ameesme/little-camera/docs/mood.md

# Mood

The camera wants to be used. Left alone it gets anxious over a week and asks for attention, the way a tamagotchi would but quieter. The face and sound follow **how long ago the last photo was taken, capped by battery level**; the daily chirp times are independent of photos. Built and running on board 1, host-tested over a simulated month, but the first real week on hardware is still ahead.

`happiness` is 1.0 the moment a photo is saved and falls linearly to 0.0 over 7 days without one. Taking a photo resets the time-based happiness and schedules a chirp about an hour later, without changing the daily chirp times. Low battery can still make a freshly used camera look and sound unhappy.

| Since last photo | Happiness | Face | Sound |
|---|---|---|---|
| 0 – 1 h | 1.0 – 0.99 | asleep, eyes lifted | happy; extra chirp at ~1 h |
| 1 h – 24 h | 0.99 – 0.86 | eyes lifted | happy |
| 1 – 3 d | 0.86 – 0.57 | eyes go flat | harmonic, with the odd slide |
| 3 – 5 d | 0.57 – 0.29 | mouth stretches flat | off-scale, a sweep or short hiss creeps in |
| 5 – 7 d | 0.29 – 0.0 | mouth turned down | dissonant, noisy, sweeps both ways |
| > 7 d | 0.0 | as sad as it gets | the same, no further escalation |

The eyes carry the happiness, so the happy face needs no smile — just lifted eyes over the same square mouth. Below the top band they go flat and stay flat and the mouth does the rest. The face breathes for its first two minutes, and a tap restarts that window, since it means someone is there. After it the sleep tick stretches to 60 s, still checking for due chirps.

## Battery mood

The battery icon and mood use the same hysteretic bars from `power.h`:

- **Low (two bars):** happiness is capped at 127, the glum band. Enter below 35%; recover to three bars at 45%.
- **Empty (one bar):** happiness is capped at 63, the sad band. Enter below 15%; recover to two bars at 20%. “Empty” here means the icon's empty state, not a zero-volt battery.
- Battery can only worsen the time-based mood. A naturally sad camera stays sad when charged; charging removes the battery limit as its percentage recovers.

This is applied to sleep and awake faces, mood chirps and the `happiness` sent to the phone. The happy charger-connection chirp remains an acknowledgement of power arriving. Battery does not change photo timestamps, the neglect clock, the daily chirp schedule or the persisted time-based mood. ADC samples are shared with telemetry, refreshed at most every five seconds in the viewfinder or when charge/USB status changes; sleep continues using its existing battery ticks.

## The rules

- **Time spent powered off does not count.** There is no clock battery, so mood state is persisted in NVS and resumed on boot: a camera that was sad when the battery died wakes up just as sad as it was, and catches up as soon as a phone sends the date. Durations are known from the first boot; the time of day only after a `SET_TIME` with a UTC offset (`protocol.md` §3).
- **Three or four attention chirp times are picked at random each day**, between 08:00 and 22:00 local, in addition to the chirp 55–65 minutes after a photo. They start on the first day and taking photos does not reset them. The schedule is persisted so restarting does not re-roll it. On a partial first day, past times are skipped; missed times do not pile up into a burst.
- **Before local time is known**, the daily schedule uses repeating 24-hour periods of powered-on time, resumed across restarts, with random times throughout each period. Once the phone supplies local time, it switches to the local day. Until the phone sets the clock again after a restart, the saved schedule clock continues from where it stopped.
- **Nothing between 22:00 and 08:00 local**, when local time is known. Before local time has ever been known, the night rule is skipped and the chirp still plays. That is deliberate: a camera that has never met a phone should still be heard.
- **A chirp waits for a quiet screen.** Only the viewfinder or the sleep face, button up, nothing playing, no transfer running. It never interrupts the save screen, the gallery or a slide.
- **A tap on a sleeping camera answers in its current mood** without waking it and without counting as activity, so a press in a bag both explains itself and says how the camera is doing.
- **Every chirp is composed on the spot.** The score is a pure function of a seed and the happiness, so any chirp can be reproduced on a laptop: `tools/chirp` renders scores to WAV and `tools/hosttest` checks the invariants (≤300 ms, 2–3 segments, the A major scale while happy).

## Testing it

`tools/hosttest` runs a simulated month through the state machine and checks every rule above. On the bench, `-DLC_MOOD_FAST` runs the mood clock 600× — the week in about seventeen minutes — so the whole arc plays out in one sitting, faces included. Every chirp and state save is a serial line.

Open: whether the one-hour chirp should also play while the phone is syncing. It waits today.
