ameesme/little-camera/docs/protocol.md

# Little Camera protocol

The single source of truth for how the three parties talk. The firmware (`firmware/src/sync.cpp`), the iOS bridge (`app/ios/LittleCamera/BLE/Protocol.swift`) and the server (`server/src/routes/camera.ts`) are all written from this file. Change it here first.

```
┌──────────┐   BLE (GATT)   ┌──────────┐   HTTPS (JSON / PBM)   ┌──────────┐
│  camera  │ ─────────────▶ │  iPhone  │ ─────────────────────▶ │  server  │
│ ESP32-S3 │ ◀───────────── │  bridge  │ ◀───────────────────── │  blog    │
└──────────┘                └──────────┘                        └──────────┘
```

The phone is a dumb pipe. It never authenticates as a person; it authenticates **as the camera**, using an id and a secret it read from the camera over an encrypted BLE link. Making a blog, showing the QR verification picture and approving subscribers are all camera-scoped API calls the app makes; the web keeps only the two things a person must do out of band, in their own mail client: confirming the address and letting a phone in. Firmware travels the same pipe backwards — server to phone over HTTPS (§4.7), phone to camera over BLE (§3.7) — and is verified at the far end, so the pipe stays dumb.

Hosts: the service is `lttl.cam`. A blog is one label under it (`mees.lttl.cam`), the landing page owns `lttl.cam/`, and everything this server answers on that domain sits under `/api` (machines) or `/app` (people) so a proxy can tell the two apart.

All multi-byte integers on BLE are **little-endian**. All timestamps are **unix seconds, UTC**.

---

## 1. Identity

| Name | Definition | Example |
|---|---|---|
| `camera_id` | The camera's Bluetooth MAC (`esp_read_mac(..., ESP_MAC_BT)`), 12 lowercase hex characters, no separators | `7cdfa1e2b3c4` |
| `secret` | 16 random bytes generated once on first boot (`esp_fill_random`), stored in NVS. Sent as 32 lowercase hex characters over HTTP | `9f2c…` |
| `short_code` | 6 characters derived from `camera_id` (below). Shown in the app and on the camera, so a human can tell two cameras apart | `KQ7M2X` |
| BLE device name | `lc-` + last 4 hex characters of `camera_id`, uppercase | `lc-B3C4` |

### Alphabet

Codes that a human may have to read or type use this 32-character alphabet (no `0 O 1 I`):

```
ABCDEFGHJKLMNPQRSTUVWXYZ23456789
```

Index 0 = `A` … index 31 = `9`.

### `short_code` derivation

```
h = sha256(ascii bytes of camera_id)          # 32 bytes
v = h[0]<<32 | h[1]<<24 | h[2]<<16 | h[3]<<8 | h[4]   # first 40 bits, big-endian
code = ""
for i in 0..5:
    code += ALPHABET[(v >> (35 - 5*i)) & 31]   # six 5-bit groups from the top, 30 bits used
```

Test vectors (the C, Swift and TS implementations are all checked against these):

| `camera_id` | `short_code` |
|---|---|
| `7cdfa1e2b3c4` | `MM48F3` |
| `000000000000` | `882TLC` |
| `ffffffffffff` | `XMPHSF` |
| `a1b2c3d4e5f6` | `ZZWB7E` |

---

## 2. Photo file format

Photos are binary **PBM (P4)**, 320×240, exactly as the firmware stores them. A set bit is **black** (PBM convention). Rows are 40 bytes, MSB first, no padding. Files written by firmware from this version on carry one comment line:

```
P4
# boot=17 up=48213 t=1757789000
320 240
<9600 bytes of raster>
```

| Field | Meaning |
|---|---|
| `boot` | Boot counter (NVS) at capture time |
| `up` | `millis()` at capture time |
| `t` | Unix time at capture time, `0` if the camera did not know the time (no phone had connected since boot) |

Files from older firmware have no comment line. Every reader must accept both. Readers must skip any `#` comment between tokens, per the PBM spec.

Dating rule (applied by the phone at sync time, and by the server as a fallback):

1. `t > 0` → `captured_at = t`, source `camera`.
2. else if `boot == Info.boot` (same boot as now) → `captured_at = now − (Info.uptime_ms − up) / 1000`, source `phone`.
3. else → `captured_at = upload time`, source `upload`. Ordering by `camera_index` is preserved server-side by subtracting one second per position when several such photos arrive in one batch.

---

## 3. BLE GATT service

Base UUID `1C0000xx-4C43-4D52-8000-6C6974746C65` (`4C43 4D52` = "LCMR", suffix spells `little`).

| xx | Name | Properties | Size |
|---|---|---|---|
| `01` | Service | advertised in the primary advertisement | |
| `02` | `Info` | READ | 25 bytes |
| `03` | `Secret` | READ, **encrypted + authenticated** (bonded, passkey) | 16 bytes |
| `04` | `Control` | WRITE (with response) | 1–37 bytes |
| `05` | `Data` | NOTIFY | up to MTU − 3 |
| `06` | `Update` | WRITE (without response) | up to MTU − 3 |

Advertising: connectable, 100 ms interval, service UUID `…01` in the advertisement so iOS background scans match it. The camera advertises while awake and for a while behind the sleep face, not in light sleep (see §3.6).

MTU: the camera requests 512. The usable notification payload is `MTU − 3` ATT bytes; the frame header takes 3, so `chunk = MTU − 6` (iOS typically grants 185 or 251 → 179 or 245-byte chunks; a 9.6 KB photo is ~40–55 notifications).

### 3.1 `Info` (READ)

| Offset | Type | Field |
|---|---|---|
| 0 | u8 | `version` = 3 |
| 1 | u8[6] | `mac` (same bytes as `camera_id`, in order) |
| 7 | u16 | `photo_count` |
| 9 | u16 | `unsynced_count` |
| 11 | u16 | `newest_index` (0 if no photos) |
| 13 | u16 | `boot` |
| 15 | u32 | `uptime_ms` |
| 19 | u32 | `epoch` (0 if the clock is unset) |
| 23 | u8 | `flags`: bit0 `time_valid`, bit1 `storage_ok`, bit2 `busy` (a stream is running), bit3 `trial` (running an update that has not been confirmed yet, §7), bit4 `usb` (VBUS present), bit5 `charging` (VBUS present and the charger pulling) |
| 24 | u8 | `fw_major` |
| 25 | u8 | `fw_minor` |
| 26 | u8 | `fw_patch` |
| 27 | u8 | `update_state` (§3.7: 0 idle, 1 receiving, 2 verifying, 3 ready, 4 failed) |
| 28 | u32 | `update_space` — bytes the inactive firmware slot can take, 0 if the camera cannot update itself |
| 32 | u16 | `vbat_mv` — battery millivolts, the mean of 16 ADC reads doubled back through the 1M/1M divider |
| 34 | u8 | `battery_percent` — 0–100, the camera's own reading of its curve |
| 35 | u32 | `used_bytes` — LittleFS bytes in use |
| 39 | u32 | `total_bytes` — LittleFS bytes total, 0 if the mount failed |
| 43 | u8 | `happiness` — 0–255 ([mood](mood.md)), including battery mood limits: low caps at glum (127), empty at sad (63), following the camera's battery bars and hysteresis. The face is `happiness >> 6`, the same split the camera draws |
| 44 | u32 | `mood_elapsed_s` — seconds since the last photo on the mood clock, which runs without a wall clock |

48 bytes. Read it after connecting and after every `ACK`; it is not notified.

**The percentage comes from the camera, not from the reader.** `vbat_mv` is there to be shown beside it and to calibrate the curve against a real discharge, not for a phone to invent its own number from. On USB the charge current pulls the reading up, which is what `charging` is for: show the percentage and say it is charging, rather than pretending the number means the same thing.

### 3.2 `Secret` (READ, encrypted)

16 raw bytes. Reading it triggers pairing on first contact: the camera uses **passkey display** — the six digits take over its screen (`Display::drawPairing`, not a toast) until the phone reports the outcome or a minute passes — and the phone asks the user to type them. After bonding the read succeeds silently on every reconnect. The phone stores the secret in the Keychain and never asks again.

### 3.3 `Control` (WRITE)

`[u8 op][args…]`

| op | Name | Args | Effect |
|---|---|---|---|
| `0x01` | `SET_TIME` | `u32 epoch` [, `i16 utc_offset_min`] | Sets the camera clock. Photos taken afterwards carry `t=`. The optional offset (minutes east of UTC, e.g. 120 for CEST) gives the camera local time for its night rule ([mood.md](mood.md)); a 4-byte write is still accepted and leaves any stored offset alone |
| `0x02` | `LIST` | `u16 from_index`, `u8 flags` (bit0 = unsynced only) | Streams `LIST_DATA` frames, ascending index, starting at `from_index` (inclusive) |
| `0x03` | `GET` | `u16 index`, `u32 offset` | Streams the raw file (header + raster) from `offset` as `PHOTO_DATA` frames |
| `0x04` | `ACK` | `u16 index` | The phone has the file safely. Camera marks it synced (rename `/0007.pbm` → `/0007s.pbm`) |
| `0x05` | `DELETE` | `u16 index` | Deletes the file. The bridge does not use this by default |
| `0x06` | `ABORT` | | Stops the running stream |
| `0x07` | `PROMPT` | `u8 kind` | What the phone is waiting for: `0` nothing, `1` the verification card (§5), `2` the picture that heads the blog, `3` say hello (the phone is showing the owner that the two have found each other, so the panel says it too and returns by itself). The camera wakes if it was asleep, names the shot on its own screen, and goes back to `0` by itself once a photo is saved. Purely cosmetic: the kind of an uploaded photo is still decided server-side (§4.3) |
| `0x08` | `CHIRP` | `u8 times` (1..3) | The camera chirps in its current mood, that many times. For a step on the phone that the camera should be noticed for; it draws nothing and changes nothing |
| `0x10` | `UPDATE_BEGIN` | `u32 size`, `u8[32] sha256` | Opens a firmware update session (§3.7) for an image of `size` bytes with that SHA-256. Answered with `UPDATE_STATUS` |
| `0x11` | `UPDATE_END` | | Every byte is in: verify, arm the new slot, reboot |
| `0x12` | `UPDATE_ABORT` | | Throws the half-written image away. The running firmware is untouched |

Only one stream runs at a time; a `LIST`/`GET` while busy ends immediately with status `busy`. An open update session counts as busy for both, and `UPDATE_BEGIN` while a photo stream runs is answered `busy` in turn. Writes are processed on the camera's main loop, not in the BLE callback, so a response frame can lag a write by one loop iteration (~30 ms).

### 3.4 `Data` (NOTIFY)

Frame: `[u8 kind][u16 seq][payload]`

| kind | Name | Payload |
|---|---|---|
| `0x01` | `LIST_DATA` | 1..N entries of 16 bytes (below) |
| `0x02` | `PHOTO_DATA` | raw file bytes |
| `0x03` | `UPDATE_STATUS` | 15 bytes, §3.7 |
| `0x7F` | `END` | `u8 op`, `u8 status`, `u32 total_len`, `u32 crc32` |

`seq` starts at 0 for each stream and increments by one per frame; `END` carries the next value. `total_len` is the number of payload bytes streamed (for `GET`: bytes from `offset` to end of file). `crc32` is the IEEE CRC-32 of those payload bytes (for `GET` with `offset > 0` it covers only the streamed part). An update session is a stream of its own for this purpose: `seq` restarts at 0 on `UPDATE_BEGIN` and counts `UPDATE_STATUS` frames.

`status`: `0` ok, `1` not found, `2` aborted, `3` storage error, `4` busy, `5` bad image, `6` offset (resume at `next_offset`), `7` too large.

`LIST_DATA` entry (16 bytes):

| Offset | Type | Field |
|---|---|---|
| 0 | u16 | `index` |
| 2 | u8 | `flags`: bit0 `synced`, bit1 `epoch_is_estimate` (from uptime), bit2 `epoch_from_clock` |
| 3 | u8 | reserved |
| 4 | u32 | `size` (bytes on disk, header included) |
| 8 | u32 | `epoch` (0 unknown; already computed with the dating rule in §2 where possible) |
| 12 | u32 | `uptime_ms` at capture (`up`) |

### 3.5 Bridge algorithm (what the phone does on every connection)

```
connect → read Info → if Secret unknown: read Secret (pair)
SET_TIME(now, utc_offset_min)
LIST(from_index = 1, flags = unsynced_only)
for each entry ascending:
    GET(index, 0)                     # resume with offset after a disconnect
    verify seq continuity + crc32
    upload to server (§4.3); 200/201/409 all count as success
    ACK(index)
read Info; done when unsynced_count == 0
```

### 3.6 Power rules

- The camera runs the radio while awake and for 30 s after the 20 s idle timeout: the sleep face is already up, but the chip keeps advertising behind it, which gives a backgrounded iPhone time to notice.
- While a phone is connected and active (connect, write, notification, ACK within the last 60 s) that window stretches.
- Then light sleep tears the BLE stack down; a one-second hold on the shutter wakes the camera and brings the radio back.
- Pressing the shutter always wins; a transfer in progress simply continues alongside.
- A firmware update (§3.7) holds the camera awake for as long as it runs: no idle timeout, no light sleep, and the sensor is powered down to leave the radio and the flash writer alone.

### 3.7 Firmware update session

The phone pushes an image to the camera's spare firmware slot. Why this shape:
the camera is a peripheral and cannot fetch anything itself, the ESP32-S3 has a
second 3.3 MB app slot sitting empty, and the whole point is that nothing the
phone does to a half-written slot can stop the camera from booting what it is
running now.

`Update` writes are `[u32 offset][data]`, written **without response** — one ATT
acknowledgement per 500 bytes would halve the throughput and the offset already
makes a lost write recoverable. The camera only accepts `offset == next_offset`;
anything else is dropped and answered with status `offset` carrying the offset
it does want, and the phone rewinds there.

Flow control is a window, because the camera stages chunks in RAM and writes
them to flash from its main loop, and a phone that outruns it would lose the
overflow. `UPDATE_BEGIN` answers with the `chunk` and `window` the camera can
take; the phone may have `window` bytes outstanding beyond the last
`next_offset` it was told, and the camera sends an unsolicited `UPDATE_STATUS`
(`op = 0x00`) roughly every half window to move it along — and always on the
last byte of the image, however little of a window it took, since that is the
one the phone is waiting for before it sends `UPDATE_END`.

`UPDATE_STATUS` payload (15 bytes):

| Offset | Type | Field |
|---|---|---|
| 0 | u8 | `op` — the control op this answers, or `0x00` for a progress report |
| 1 | u8 | `status` (§3.4) |
| 2 | u8 | `state`: 0 idle, 1 receiving, 2 verifying, 3 ready (about to reboot), 4 failed |
| 3 | u32 | `next_offset` — what the camera wants next, i.e. how much it has accepted |
| 7 | u32 | `total` — the size it is expecting |
| 11 | u16 | `chunk` — most data bytes per `Update` write |
| 13 | u16 | `window` — bytes the phone may have in flight beyond `next_offset` |

What the phone does:

```
read Info                                  # version >= 2 and update_space >= size, or stop
UPDATE_BEGIN(size, sha256)
→ UPDATE_STATUS(status=ok, next_offset, chunk, window)   # next_offset > 0 resumes a session
while next_offset < size:
    write [next_offset][chunk bytes] until window is full, then wait for UPDATE_STATUS
    status=offset → rewind to the next_offset it reports
UPDATE_END
→ UPDATE_STATUS(status=ok, state=ready)    # then the camera reboots; the link drops
   status=offset → the camera is short after all; fill the gap and end again
reconnect, read Info, check fw_* is the new version
```

An `UPDATE_END` that arrives before every byte did is answered `offset`, not
`bad image`: a gap at the end is worth going back for, and the image on the
camera is only incomplete, not wrong. A session the phone abandons is not
ended by a disconnect either — the camera holds the half-written slot for 90
seconds, so reconnecting and repeating `UPDATE_BEGIN` with the same digest
resumes it rather than starting a megabyte again.

The camera's side of the bargain, which is what keeps a partial flash from
bricking it:

1. Bytes go to the **inactive** slot. The running firmware is never touched, so
   an abandoned update costs nothing but the re-send.
2. The slot is armed only after all `size` bytes arrived, the SHA-256 of the
   stream matches the one in `UPDATE_BEGIN`, and the bootloader's own image
   check passes.
3. The first boot of a new image is a **trial**: `Info.flags` bit3 says so. The
   firmware confirms itself once it is up and running; an image that crashes
   before that, three boots in a row, is rolled back to the slot it came from.
4. `UPDATE_ABORT`, a disconnect, or a camera reset during the transfer all end
   in the same place: the old firmware, still running, still bootable.

---

## 4. HTTP camera API

Base: `https://lttl.cam/api/camera`. JSON unless noted. Errors are `{ "error": "<code>", "message": "<human text>" }`.

Only two prefixes on that domain are the server's: `/api/…` for machines and `/app/…` for the two pages an emailed link opens — `/app/verify-email` and `/app/claim`. There is no owner session and no management on the web: the app does all of it over this API. Everything else, `/` above all, belongs to the landing page behind the same proxy. Blogs are unaffected, each owning the root of its own subdomain.

### 4.1 Authentication

```
Authorization: Camera <camera_id>:<secret_hex>
```

Every route except `hello` requires it. The server stores `sha256(secret)` and compares in constant time.

### 4.2 `POST /hello`

Body `{ "camera_id": "7cdfa1e2b3c4", "secret": "<32 hex>", "firmware": "0.2.0" }`.
First contact creates the camera (trust on first use). Later calls must present the same secret.
`firmware` is optional — the bridge sends what `Info` reported — and is only recorded, never trusted for anything.

Response `200`:

```json
{
  "camera_id": "7cdfa1e2b3c4",
  "short_code": "KQ7M2X",
  "bound": null | { "handle": "mees", "name": "Mees", "url": "https://mees.lttl.cam" },
  "server_time": 1757789000
}
```

### 4.3 `POST /photos`

Raw PBM body.

| Header | Required | Meaning |
|---|---|---|
| `Content-Type: image/x-portable-bitmap` | yes | |
| `X-Photo-Index: 7` | yes | `index` on the camera |
| `X-Captured-At: 1757789000` | no | phone's estimate when the file has `t=0` |
| `X-Captured-At-Source: phone` | no | `phone` or `upload` |

Size limit 16 KB. Must parse as `P4 320 240`.

Response `201` (new) or `200` (`"status": "duplicate"`, same `camera_id` + sha256 seen before):

```json
{
  "id": "k3m9q2z8x1w4",
  "status": "stored" | "duplicate",
  "kind": "photo" | "verification" | "avatar",
  "bound": null | { "handle": "mees", "name": "Mees", "url": "https://mees.lttl.cam" }
}
```

Server-side, in order: parse + hash → dedupe → date (rule in §2) → if the camera is unbound and any verification code is live, try to decode a QR (§5) → if bound and an avatar was requested and `captured_at` is after the request, this photo becomes the avatar.

### 4.4 `GET /status`

```json
{
  "camera_id": "7cdfa1e2b3c4",
  "short_code": "KQ7M2X",
  "bound": null | { "handle": "mees", "name": "Mees", "url": "…", "photo_count": 12 },
  "avatar": { "requested_at": 1757789000 | null, "has_avatar": false },
  "firmware": { "installed": "0.2.0" | null, "latest": null | { "version": "0.3.0", "size": 1481712, "sha256": "…", "url": "…", "notes": "…", "released_at": 1757789000 }, "update_available": false },
  "claim": "unbound" | "pending" | "approved",
  "pending": null | { "handle": "mees", "name": "Mees", "verified": false },
  "confirmed_email": null | "mees@example.com",
  "subscribers": [ { "id": 3, "email": "sanne@example.com", "name": "Sanne" | null, "status": "pending" | "approved" | "blocked", "added_by": "self" | "owner" } ],
  "server_time": 1757789000
}
```

`subscribers` is empty and `bound` is `null` until the camera is bound. `pending` is the blog this camera is being
set up for but has not photographed the code of yet (§4.9 approved it, §5 has not bound it), with `verified` saying
whether its address has been confirmed; it is how a phone that was closed mid-onboarding picks up where it left off
instead of making the blog a second time. `confirmed_email` is an address whose owner has opened the link in §4.9 but
has not named a blog yet, and is what `POST /blog` makes one from. `claim` is how far the phone has got with §4.9; the battery and the rest of the camera's own state are not here, because the phone reads them off `Info` (§3.1) and sends them the other way (§4.8).

### 4.5 Subscribers (bound cameras only)

- `POST /subscribers` `{ "email": "…", "name": "…" | null }` → `201 { "id": 4 }`. Owner-added subscribers are approved immediately and receive a welcome link.
- `POST /subscribers/:id/approve` → `200`. Sends the welcome link.
- `POST /subscribers/:id/block` → `200`. Reversible.
- `DELETE /subscribers/:id` → `200`. Not reversible: the row and its comments go.

### 4.6 `POST /request-avatar`

`{}` → `200 { "requested_at": 1757789000 }`. The next photo captured after this moment becomes the profile picture.

### 4.7 `GET /feed` (bound and claimed)

The owner's own blog as data, newest first. `403 unclaimed` until §4.9 is through.

```json
{
  "photos": [ { "id": "5jk7ferd11ap", "url": "…/photos/5jk7ferd11ap.png", "kind": "photo" | "avatar", "captured_at": 1757789000, "uploaded_at": 1757789100, "comments": [ { "id": 1, "name": "Sanne", "body": "…", "created_at": 1757789200 } ] } ],
  "next": "1757789100.0" | null
}
```

Twenty a page. Pass `next` back as `?before=` for the next one.

- `POST /feed/:id/comments` `{ "body": "…" }` → `201 { "name": "Mees" }`. The owner's own comment, under the blog's name: a claimed camera's blog is the owner's (§4.9), so the phone needs nothing further.
- `DELETE /feed/:id` → `200 { "ok": true }`. Takes the `id` out of `photos[]`. Not reversible: the row, its comments and the stored PBM go. `404 not_found` if the photo is not on this camera's blog.

### 4.8 `POST /telemetry`

What the phone read out of `Info` (§3.1), relayed so the blog and the app can show it:

```json
{ "battery_percent": 44, "battery_mv": 3820, "charging": false, "used_bytes": 1234567, "total_bytes": 6553600, "happiness": 200, "mood_elapsed_s": 90061 }
```

Stored as given. **The percentage is the camera's**: the server does not recompute it, and the blog shows no battery at all until a phone has sent one, because an invented number is worse than none.

`GET /handle?handle=<handle>` answers `{ handle, available }`, while the owner is still typing a new one. Whether that blog has confirmed its address is `pending.verified` in §4.4; the phone waits on it before asking for the verification photo, since an unconfirmed blog is a 404 to everyone.

### 4.9 Letting a phone in

The camera credential proves a camera, not a person. Reading a blog's pictures, comments and list is a person's business, so the phone asks the owner once, by email.

**The address comes first.** Nothing is named, and no row is written, until someone has opened a link sent
to the address they typed. A half-finished sign-up leaves a token that expires, not a blog nobody confirmed.

- `POST /claim` `{}` on a bound camera, or `{ "email": "…" }` on an unbound one → `200 { "state": "pending" }` and a mail to the owner. On an unbound camera the server mails whichever link fits: an address that already owns a blog gets `/app/claim?t=…` to let this phone into it, and an address it has never seen gets `/app/confirm?t=…` to start one. **The answer is identical either way**, so the form says nothing about who has a camera, and the app shows the same screen for both.
- Opening `/app/confirm?t=…` records the address against that camera, where `confirmed_email` in §4.4 reports it. It names no blog, because there is none yet.
- `POST /blog` `{ "name": "…", "handle": "…" }` → `201 { "handle", "url" }`. Names the blog for whatever `confirmed_email` holds; the address is never sent again, because the phone does not get to choose it at this point. `409 address_unconfirmed` before that link is opened, `409 already_bound` if the camera has a blog, `409 handle_taken` otherwise. The blog is verified from birth, the phone is let in on the spot, and `confirmed_email` is cleared. Binding is still the QR photo (§5), except that the app skips it for now and the server binds here instead.
- `GET /handle?handle=…` → `200 { "handle", "available" }`. So the app can say *taken* before the form is sent.
- `POST /verification-code` `{}` → `201 { "code": "KQ7M2X", "expires_at": … }`. The code the app draws as the QR (§5). `409 no_blog` until there is a blog to bind to, `409 already_bound` once the camera is on one.
- The claim mail links to `/app/claim?t=…`, which **asks** and grants nothing; the `POST` behind its button is what approves. Mail clients prefetch links, so a GET must not be the grant. Confirming an address is not a grant — it says only that the address is reachable — so `/app/confirm` needs no such button.
- The approval names the camera *and* the blog, so a link cannot be replayed onto another phone, and an approval for one blog does not follow the camera to another.

### 4.10 Firmware releases

Two routes under `/api/firmware`, both **unauthenticated**: a firmware image is
not a secret, and leaving it open means a proxy or a CDN can cache it and a
person can `curl` it.

`GET /api/firmware/latest?hardware=v3q&channel=stable&installed=0.2.0`

```json
{
  "version": "0.3.0",
  "channel": "stable",
  "hardware": "v3q",
  "size": 1481712,
  "sha256": "<64 hex>",
  "url": "https://lttl.cam/api/firmware/v3q/0.3.0.bin",
  "notes": "Firmware update over BLE.",
  "released_at": 1757789000,
  "update_available": true
}
```

`hardware` defaults to `v3q`, `channel` to `stable`. `installed` is
optional and only decides `update_available`, which compares the two versions
as dotted numbers (`0.10.0` is newer than `0.9.9`). `404 { "error": "no_release" }`
when that channel has nothing published.

The phone offers and sends firmware only when the published version is numerically
newer than the version in the connected camera's Info. Equal, older or malformed
versions must not start a transfer, even if a cached server response says an update is available.

`GET /api/firmware/<hardware>/<version>.bin` → the image, `application/octet-stream`,
with `ETag` (its SHA-256) and an immutable `Cache-Control`. The `sha256` above
is what the phone puts in `UPDATE_BEGIN`, so the camera verifies the bytes end
to end — the server, the CDN and the phone are all in the path and none of them
is trusted with the image.

---

## 5. Verification picture

The app shows a QR code on the phone's own screen, from the code `POST /verification-code` (§4.9) hands it. Payload:

```
<6 chars from the alphabet in §1>
```

Six characters and nothing else: that is 6 bytes, which is all QR version 1 at error correction **H** holds in byte mode, and byte mode is the only one CoreImage's generator offers. A prefix would push the phone to version 2 and cost a fifth of every module's width, which the camera cannot spare. Nothing needs the prefix to tell our code apart, because only a code the server has issued and not yet expired binds anything.

QR version 1 (21×21 modules), error correction **H**, rendered as large as the phone's screen allows with a 4-module quiet zone on white. Code lifetime 15 minutes; the app asks for a fresh one when it expires.

The server decodes the uploaded 1-bit photo with these variants until one yields `^[A-Z2-9]{6}$`, stopping at the first hit: nearest-neighbour scale `{2, 3, 1}` as-is, then a greyscale box blur of radius `{1, 2}` at scale `{2, 3}`, then the 3×3 majority filter at scale `{2, 3, 1}`, all with both polarities. The blur is what reads a photo of a phone screen: the camera's dither speckles a white module at about the module spacing, and averaging the window back into grey undoes what the one-bit file threw away. A match binds `camera_id` to the blog, tags the photo `kind = verification`, back-fills the camera's unclaimed photos onto the blog and emails the owner.

Photographing a QR code is the only way to bind, and it works on a camera that is already bound: whoever holds the camera can move it to another blog. Photos stay with the blog they were posted to, so a rebind takes the camera and not the history.

---

## 6. USB serial console (export fallback)

The firmware answers on the USB-CDC console (115200). Lines end with `\n`.

| Command | Reply |
|---|---|
| `ls` | one line per photo: `<index> <size> <synced 0/1>`, then `ok` |
| `get <index>` | `begin <index> <size>`, then the file as hex, 64 bytes per line, then `end <crc32 hex>` |
| `stat` | `photos=<n> unsynced=<n> used=<bytes> total=<bytes> boot=<n> id=<camera_id> code=<short_code> fw=<version>` |
| `log` | `begin <size>`, then `/debug.log` verbatim, then `end` |
| `log clear` | `ok` / `err` |
| `ota` | `fw=<version> running=<partition> state=<name> trial=<0/1> other=<partition> space=<bytes>` |
| `ota revert` | Boots the other slot next time, if it holds a valid image: `ok <partition>`, then a reboot. `err …` otherwise |

Anything else → `err unknown`. `firmware/tools/export/pull_serial.py` speaks this.

`/debug.log` is a debugging aid, not part of the product: lines are `uptime_s,mv,chg`, one standby battery sample every 5 minutes behind the sleep face and one whenever the charge state changes. It exists because a sleeping camera cannot be reached over USB, so a standby run has to be read back afterwards.

`ota revert` is also the way back after a BLE update: a USB `pio run -t upload` writes the *first* slot, but the bootloader still points at the second, so the board would keep booting the image the phone sent. Revert first, or erase the OTA data (`esptool.py erase_region 0xe000 0x2000`), and photos stay untouched either way.
