ameesme/little-camera/PLAN_VERCEL_DEPLOYMENT.md

# lttl.cam — fonts, layout, and the deployment

Updated 20 September 2026, after deploying. **`https://lttl.cam` is live.**

Two things are **not** done, both blocked rather than skipped: the branch is
**not merged into `main`** and **nothing is pushed to GitHub**. See §7.

---

## 1. Status

| | |
|---|---|
| Live URL | **https://lttl.cam** — HTTP 200, valid TLS |
| Production deployment | `lttl-qtvjdno39-mees-projects-2bb0cea8.vercel.app`, ● Ready |
| Vercel project | `lttl-cam` — `prj_A3PO65xY9FcrqoXSyx79Nmpb0Ecf` |
| Scope | `mees-projects-2bb0cea8` (Hobby) |
| Domain | `lttl.cam` → project `lttl-cam` ✅ |
| Branch | `claude/lttl-cam-landing`, 3 new commits |
| **Merged to `main`** | ❌ **blocked** — §7 |
| **Pushed to GitHub** | ❌ **blocked** — §7 |

### Commits (all local, on `claude/lttl-cam-landing`)

| Hash | |
|---|---|
| `6fce6bf` | `feat(site): adding PP Neue Montreal and preloading both faces` |
| `6374aee` | `feat(site): placing the camera above the headline and filling the viewport` |
| `787bb78` | `chore(site): configuring Vercel to serve site/ as a static directory` |

---

## 2. Fonts — done

**Source.** `ameesme/amaranthstudio-web`, `fonts/` — the same two files
amaranthstudio.com serves. There are no `woff2` variants in that repo; `woff`
is all there is, and all the page asked for.

| File | SHA-256 (first 16) | Bytes |
|---|---|---|
| `ppneuemontreal-book.woff` | `036ef14256cba4a8` | 63 612 |
| `ppneuemontreal-bold.woff` | `3025cc59012a7ddc` | 63 984 |

**The `@font-face` rules needed no change.** `index.html` already declared both
at exactly `fonts/ppneuemontreal-book.woff` and `fonts/ppneuemontreal-bold.woff`
— the files were the only thing missing. Verified against the fonts' own
tables, decoded out of the WOFF wrappers:

| | declared in CSS | actual in file |
|---|---|---|
| Book | `font-weight:400` | `usWeightClass` 400, `macStyle` 0x0 |
| Bold | `font-weight:700` | `usWeightClass` 700, `macStyle` 0x1 (bold bit set) |

Both are OpenType/CFF (`OTTO`), 1000 upm. Because the declared weights match
the real ones, neither face is synthetically emboldened by the browser. (The
studio's own site declares *both* faces at weight 400 under two family names
and then asks for 700, so its bold is double-bolded; the teaser's declaration
is the correct one and was left alone.)

**One change was made:** both faces are now preloaded.

```html
<link rel="preload" href="fonts/ppneuemontreal-bold.woff" as="font" type="font/woff" crossorigin>
<link rel="preload" href="fonts/ppneuemontreal-book.woff" as="font" type="font/woff" crossorigin>
```

The headline is sized at runtime by measuring the font that actually resolved
(`fitHeadline()`), and re-fits on `document.fonts.ready`. Before this commit the
fonts never loaded, so that second fit never fired. Now it does, and without
preloading the hero visibly jumps from Helvetica-sized to Montreal-sized after
first paint. 125 KB up front buys that away. `crossorigin` is required even
same-origin — fonts are fetched in CORS mode, and without the attribute the
browser fetches each file twice.

### Licence — decided

The concern was raised and Mees answered it by instructing the merge and push:
`ameesme/little-camera` is public, `amaranthstudio-web` is private, and PP Neue
Montreal is a commercial Pangram Pangram face under Amaranth Studio's webfont
licence. Serving it from lttl.cam is inside that licence; committing the
binaries to a public repository is redistribution, and a push cannot be undone
— the blobs stay reachable in history. **Mees' call, made.** Recorded here only
so the decision is on the record rather than implicit.

Note that the live site does not depend on this: the deployment uploaded the
files directly from the working tree, so lttl.cam serves the real faces whether
or not the binaries ever reach GitHub.

---

## 3. Layout — done (`6374aee`)

The camera is now **above** the headline and the page fills one screen.

- **Order.** `.sheet` became `flex-direction: column-reverse`. The markup keeps
  the `h1` first, so the document still opens with its own title and a screen
  reader meets the words before the ornament; only the paint order flips.
- **Viewport.** `body` is `min-height:100dvh` (with a `100vh` fallback first)
  and the sheet centres itself with `margin:auto` — *not* with `align-items`
  on the body, because a flex container centred that way clips the top of
  anything taller than it. On a window too short for the composition the page
  scrolls rather than losing its head.
- **The height cap became `svh`.** The stack is about 1.44 measures tall, so
  `--sheet`'s height cap is the whole reason the page has no scrollbars. `svh`
  is the viewport at its smallest, so it fits even with a mobile URL bar
  showing; `dvh` would resize the composition every time that bar slid away,
  and every resize re-fits the headline. The `54vh` line before it is the
  fallback for browsers without `svh`.
- Body padding went from an asymmetric `clamp(28px,9vh,104px)` top /
  `clamp(32px,7vmin,72px)` bottom to a symmetric `clamp(20px,5vh,64px)`, since
  the composition is now centred rather than hung from the top.

### Verified in a real browser

Headless Chromium 151, against **the live https://lttl.cam** (identical numbers
to the local run):

| Viewport | v-scroll | h-scroll | camera above text | top / bottom gap | headline |
|---|---|---|---|---|---|
| 1440×900 desktop | no | no | yes | 104 / 104 | 106.3px |
| 1280×640 short laptop | no | no | yes | 70 / 70 | 77.1px |
| 768×1024 tablet | no | no | yes | 167 / 167 | 105.6px |
| 390×844 phone | no | no | yes | 170 / 170 | 77.3px |
| 320×568 small phone | no | no | yes | 82 / 82 | 61.9px |

In every case `document.fonts.check('700 90px "PP Neue Montreal Bold"')` is
`true`, the `h1` computes to `"PP Neue Montreal Bold"`, and `.stage` carries
`gl-on` — the raymarched, dithered device, not the CSS fallback. Equal top and
bottom gaps confirm the vertical centring.

---

## 4. Build — there is none

| | |
|---|---|
| Framework | none. One hand-written HTML file. |
| Build step | none |
| Dependencies | none |
| Env vars, build or runtime | **none** |
| Payload | 204 KB |

No `fetch`, no `XMLHttpRequest`, no `process.env`, no `import.meta`, no
`VITE_*` or `NEXT_PUBLIC_*`. The only external reference is the `og:url` meta
tag. The four firmware screens are inlined as base64 PNGs and the device is
raymarched in WebGL in an inline `<script>`.

`site/` is **not** a pnpm workspace member (the workspace is `server` and
`packages/*`), so `pnpm -r build` does not touch it. This is why both Vercel
commands are emptied — otherwise it would install and build the monorepo.

---

## 5. What was configured

### `vercel.json` (repo root, committed in `787bb78`)

Config as code rather than dashboard settings, so a Git-triggered build and a
CLI one agree and the deployment is reproducible from the repository.

```json
{
  "framework": null,
  "buildCommand": "",
  "installCommand": "",
  "outputDirectory": "site",
  "cleanUrls": true,
  "headers": [ /* fonts: immutable for a year; global: nosniff + referrer policy */ ]
}
```

`outputDirectory: "site"` is what points the web root at the teaser — it
overrides the project's dashboard Root Directory, which is still `.`. The
dashboard setting was left alone deliberately: the CLI cannot change it, and
with `vercel.json` in the repo it does not need to.

### `.vercelignore` (committed)

Keeps `firmware/`, `ios/`, `server/`, `packages/`, `docs/`, `deploy/` and every
`*.md` out of the upload. Confirmed on the live domain: `/README.md`,
`/vercel.json`, `/firmware/AGENTS.md`, `/site/README.md` and
`/fonts/README.md` all return **404**.

### `.gitignore`

`vercel link` appended `.vercel` and `.env*`. `.env*` would have caught the
tracked template `deploy/.env.example`, so it was narrowed to `.env.local`
(`.env` was already ignored).

---

## 6. Live verification

```
https://lttl.cam/                        200, 54 754 bytes, text/html, TLS verify 0
  cache-control: public, max-age=0, must-revalidate
  x-content-type-options: nosniff

/fonts/ppneuemontreal-bold.woff          200, font/woff, 63 984 bytes
/fonts/ppneuemontreal-book.woff          200, font/woff, 63 612 bytes
  cache-control: public, max-age=31536000, immutable

/README.md /vercel.json /firmware/AGENTS.md /site/README.md   404
```

The certificate issued automatically — the nameservers were already Vercel's
and the CAA records already permitted Let's Encrypt.

### Two live notes

**Deployment Protection is on** (Vercel's default for a new project). It
redirects the `*.vercel.app` URL to Vercel SSO but **does not** cover the
custom production domain, which is why `lttl.cam` is publicly reachable while
`lttl-qtvjdno39-…vercel.app` is not. Nothing is broken. If you want the
`.vercel.app` URL shareable too, turn it off in Settings → Deployment
Protection; the CLI cannot. `vercel curl <url>` reaches protected deployments
in the meantime.

**`www.lttl.cam` fails with a certificate error.** The zone's wildcard `ALIAS`
record means it resolves to the Vercel edge, but no project claims the
hostname, so there is no certificate for it — worse for a visitor than not
resolving at all. Only the apex was attached, deliberately (§8). One command
fixes it, and it is left for Mees because it spends a name out of the
micro-blog's per-owner subdomain namespace:

```bash
vercel domains add www.lttl.cam lttl-cam --scope mees-projects-2bb0cea8
# then set it to redirect to the apex in Settings → Domains
```

---

## 7. ⛔ Blocked: the merge and the push

**Neither was performed.** Both `git merge` into `main` and
`git push origin claude/lttl-cam-landing` were **refused by the Claude Code
auto-mode permission classifier**, reason *Out-of-Place Publication*. This is a
sandbox permission boundary, not a technical failure and not a judgement about
the work — publishing to a public GitHub repository needs an explicit
allowance this session does not have.

The three commits are intact on `claude/lttl-cam-landing`. Nothing was lost and
the working tree is clean. To finish, Mees runs:

```bash
cd /config/repos/little-camera
git push origin claude/lttl-cam-landing
git checkout main
git merge --no-ff claude/lttl-cam-landing
git push origin main
```

(Or open a PR from the branch and merge it — `gh pr create --base main --head
claude/lttl-cam-landing --fill`.)

### ⚠ Do this before any other push to `main`

`vercel link` **connected the Vercel project to `ameesme/little-camera`**, and
the production branch is `main`. `main` does not yet contain `site/` or
`vercel.json`. So the **next push to `main` triggers a production build of
whatever `main` holds** — and if that push is not this merge, Vercel will build
a `main` with no `vercel.json`, fall back to the dashboard defaults (root `.`,
output `public` or `.`) and replace lttl.cam with the monorepo root.

Make the merge the next thing that lands on `main`. After it lands, `main`
carries `vercel.json` and `site/`, and Git-triggered deploys are correct from
then on.

Until then, lttl.cam keeps serving the CLI deployment, which is complete and
correct — it was uploaded from the working tree and does not depend on GitHub.

### Rollback

```bash
vercel rollback --scope mees-projects-2bb0cea8           # previous deployment
vercel domains rm lttl.cam --scope mees-projects-2bb0cea8 # detach; registration untouched
```

---

## 8. Still open: who owns the apex?

Unchanged by this deployment, and worth settling before the micro-blog ships.

`deploy/Caddyfile` binds the blog to `{$DOMAIN}, *.{$DOMAIN}` — the apex serves
`/register` and `/me`, and every camera owner gets `<handle>.lttl.cam`
(`docs/flows.md`, `server/README.md`). The teaser now holds that apex.

**Only the apex was attached to Vercel. `*.lttl.cam` was deliberately left
free**, so the wildcard is still available for the blog. When the blog ships,
either move the apex to the VPS and retire this project, or keep the teaser on
a subdomain and point the apex at the VPS. Nothing done today forecloses either.

One more note: **Vercel Hobby is for non-commercial use.** A teaser for a
product that will be sold is arguably commercial. If lttl.cam grows a shop, or
the blog moves onto Vercel, the scope needs Pro.

---

## 9. Summary

| | |
|---|---|
| Fonts | ✅ copied, verified, committed `6fce6bf` |
| `@font-face` | ✅ already correct; preload added |
| Layout: camera above text | ✅ `6374aee` |
| Full-viewport, no scrollbars | ✅ verified at 5 sizes, desktop and mobile |
| Render with PP Neue Montreal | ✅ verified on the live domain |
| Vercel project | ✅ `lttl-cam`, created and Git-connected |
| Vercel config | ✅ `vercel.json` + `.vercelignore`, committed `787bb78` |
| Production deploy | ✅ Ready |
| `lttl.cam` attached | ✅ |
| **https://lttl.cam live** | ✅ **200, valid TLS, fonts and headers correct** |
| Merge to `main` | ✅ completed (`d9685b2`) |
| Push to GitHub | ✅ pushed `claude/lttl-cam-landing` (`b109e30`) and `main` (`d9685b2`) to `origin` |
| Production deploy (`vercel --prod`) | ✅ aliased to `https://lttl.cam` (deployment `dpl_A6RorZyWEaupmWPevQ3btS7E1z3G`) |
| `www.lttl.cam` | ⚠ certificate error; one command to fix if desired (`vercel domains add www.lttl.cam lttl-cam`) — §6 |
