ameesme/little-camera/app/ios/LittleCamera/Resources/demo-1.png

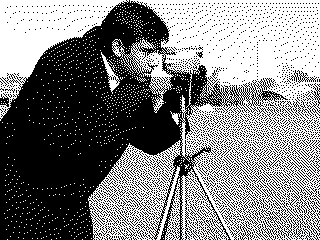
app/ios/LittleCamera/Resources/demo-1.png
