ameesme/little-camera/app/ios/LittleCamera/Resources/demo-2.png

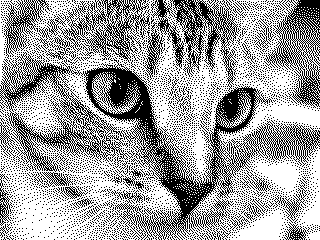
app/ios/LittleCamera/Resources/demo-2.png
