ameesme/little-camera/app/ios/LittleCamera/Resources/demo-3.png

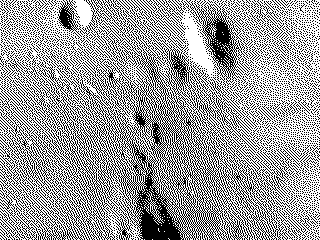
app/ios/LittleCamera/Resources/demo-3.png
