ameesme/little-camera/hardware/pcb/assets/pattern.jpg

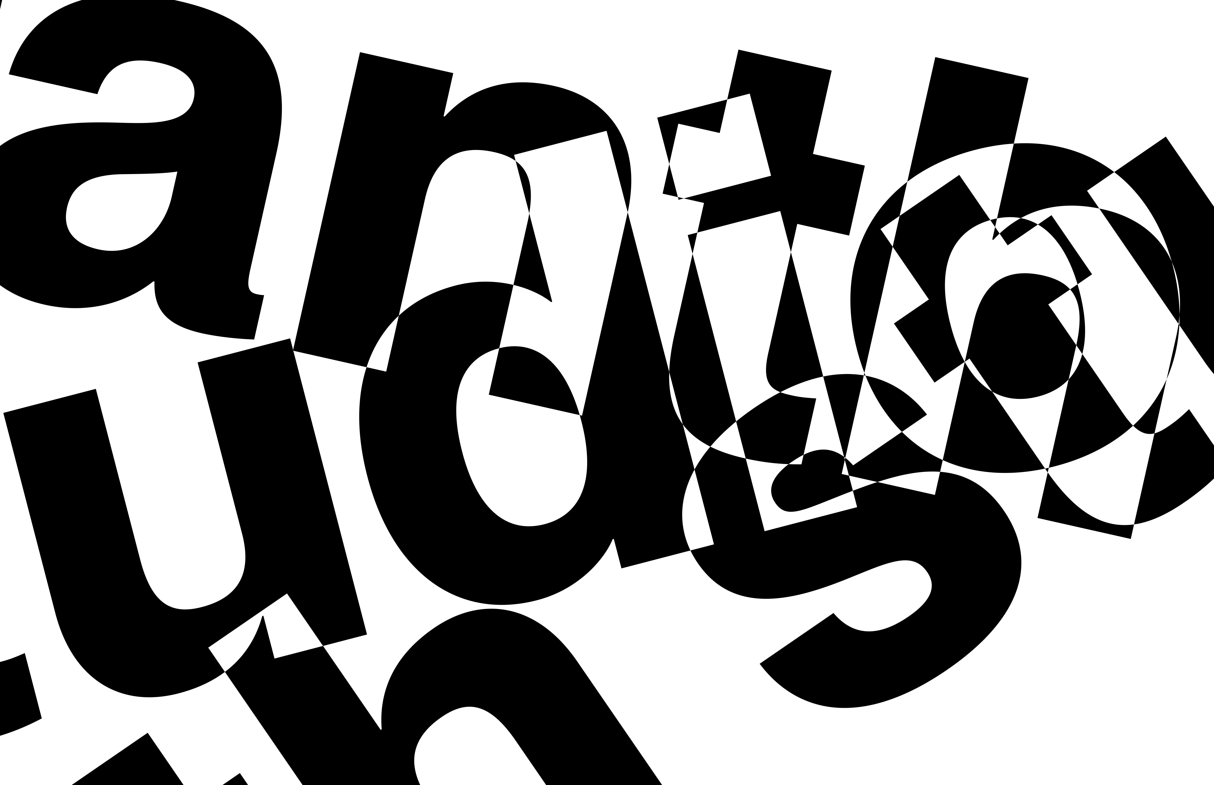
hardware/pcb/assets/pattern.jpg
