ameesme/little-camera/hardware/pcb/fab/cnc/lc_v3q_cnc_render.png

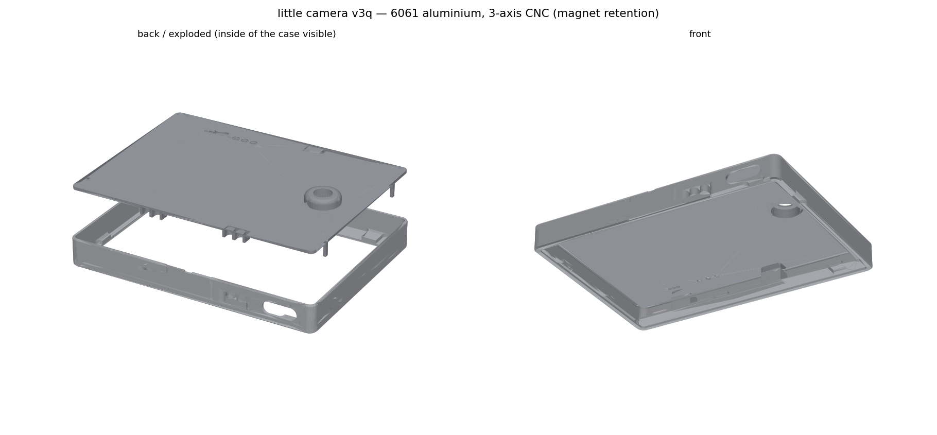
hardware/pcb/fab/cnc/lc_v3q_cnc_render.png
