ameesme/little-camera/hardware/pcb/fab/jlcpcb/jlc_panel_Y5_check.png

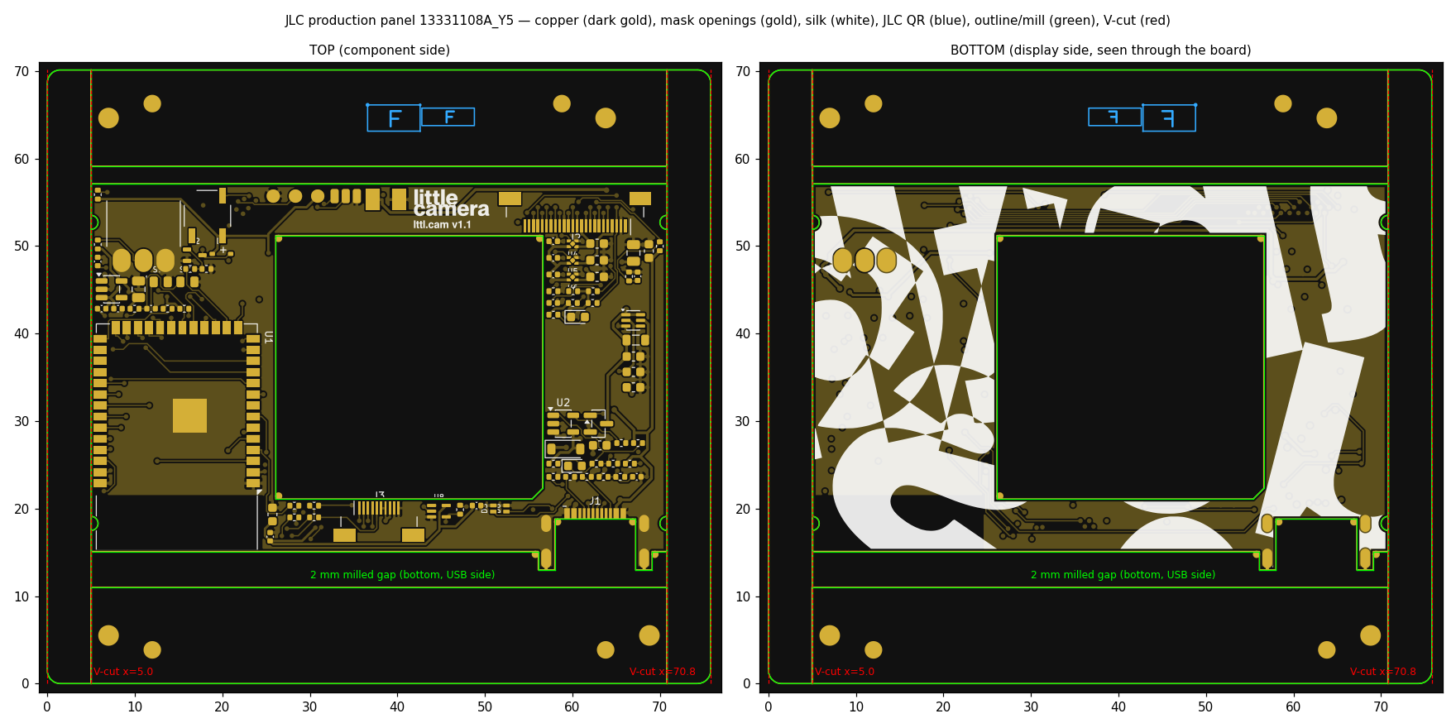
hardware/pcb/fab/jlcpcb/jlc_panel_Y5_check.png
