ameesme/little-camera/site/media/blog-strip.png

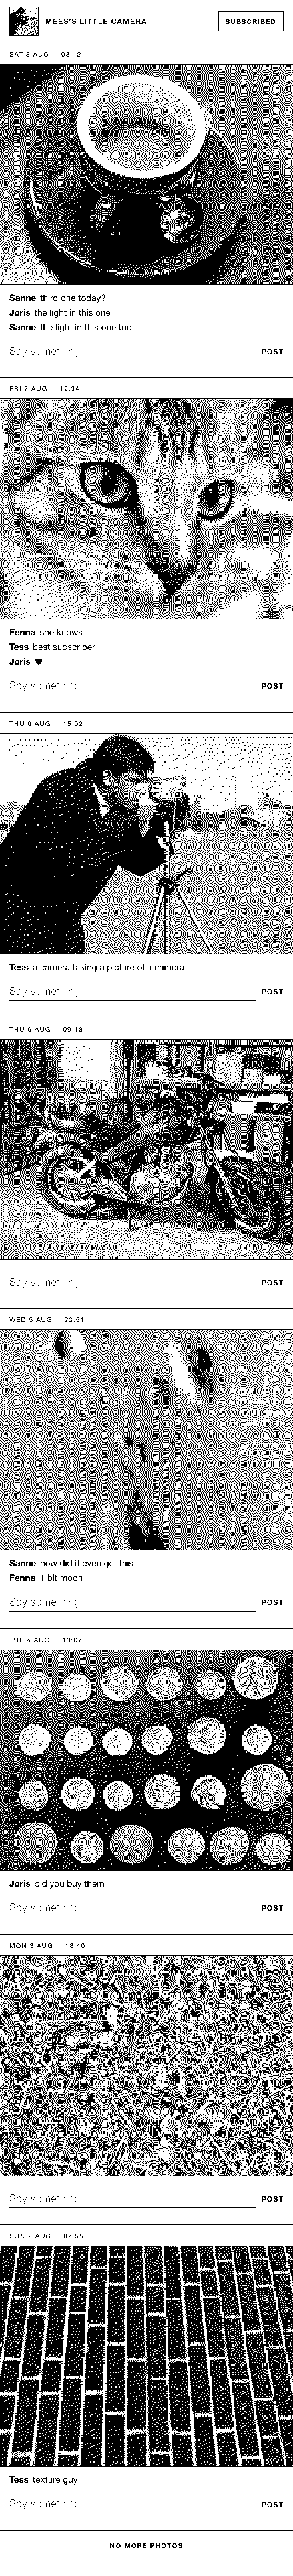
site/media/blog-strip.png
