ameesme/little-camera/site/media/og.png

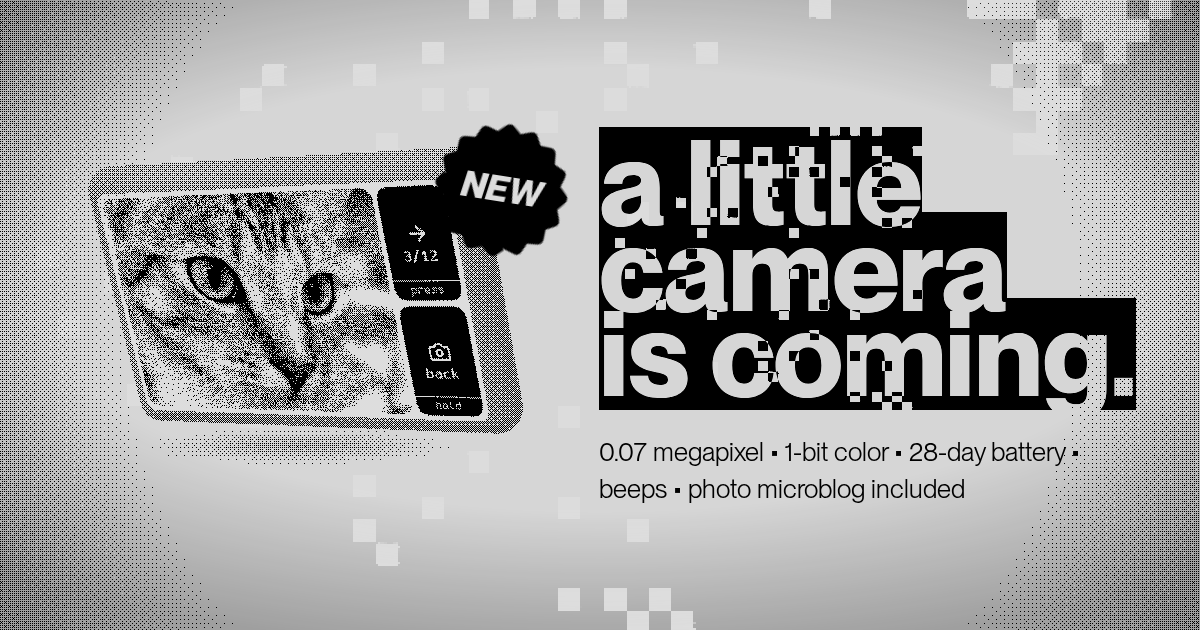
site/media/og.png
