ameesme/little-camera/hardware/pcb/fab/jlcpcb/little_camera-bom-annotated.csv

Comment | Designator | Footprint | JLCPCB Part # | Qty | MPN | Library | Stock | Note
100k | R3,R12,R28,R31 | Resistor_SMD:R_0402_1005Metric | C25741 | 4 | 0402WGF1003TCE | basic | 9158565
100nF | C6,C7,C14,C19,C20,C24 | Capacitor_SMD:C_0402_1005Metric | C1525 | 6 | CL05B104KO5NNNC | basic | 23056837 | 0402 16V X7R
10k | R13,R14,R20,R21,R26 | Resistor_SMD:R_0402_1005Metric | C25744 | 5 | 0402WGF1002TCE | basic | 22360849
1M | R4,R34,R35 | Resistor_SMD:R_0402_1005Metric | C26083 | 3 | 0402WGF1004TCE | basic | 2548709
1k | R6,R27 | Resistor_SMD:R_0402_1005Metric | C11702 | 2 | 0402WGF1001TCE | basic | 8133473
1uF | C4,C8,C10,C12,C22,C23 | Capacitor_SMD:C_0402_1005Metric | C52923 | 6 | CL05A105KA5NQNC | basic | 5951968 | 0402 25V X5R
2.2k | R17 | Resistor_SMD:R_0402_1005Metric | C25879 | 1 | 0402WGF2201TCE | basic | 2354371
200k | R19,R33 | Resistor_SMD:R_0402_1005Metric | C25764 | 2 | 0402WGF2003TCE | basic | 2347635 | R33 STAT divider, R19 VCOM oscillator (v3q)
330R | R22,R23,R24,R25 | Resistor_SMD:R_0402_1005Metric | C25104 | 4 | 0402WGF3300TCE | basic | 1251008
33k | R8 | Resistor_SMD:R_0402_1005Metric | C25779 | 1 | 0402WGF3302TCE | basic | 1208545 | v3q: VBUS divider top
4.7k | R10,R11,R15,R16 | Resistor_SMD:R_0402_1005Metric | C25900 | 4 | 0402WGF4701TCE | basic | 15730046
47k | R7 | Resistor_SMD:R_0402_1005Metric | C25792 | 1 | 0402WGF4702TCE | basic | 5630304
5.1k | R1,R2,R5 | Resistor_SMD:R_0402_1005Metric | C25905 | 3 | 0402WGF5101TCE | basic | 6263741 | USB-C CC pull-downs; R5 TP4054 charge current (196mA)
51k | R9 | Resistor_SMD:R_0402_1005Metric | C25794 | 1 | 0402WGF5102TCE | basic | 1911293 | v3q: VBUS divider bottom
10uF | C16,C17,C21 | Capacitor_SMD:C_0603_1608Metric | C96446 | 3 | CL10A106MA8NRNC | basic | 3424489 | 0603 25V X5R - chosen over the 10V basic part because C16/C17 sit on the 5V boost rail
1uF | C18 | Capacitor_SMD:C_0603_1608Metric | C15849 | 1 | CL10A105KB8NNNC | basic | 6433783 | 0603 50V X5R - VCOM oscillator timing cap
2.2uF | C9,C11,C13 | Capacitor_SMD:C_0603_1608Metric | C23630 | 3 | CL10A225KO8NNNC | basic | 2652212 | 0603 16V X5R
4.7uF | C1,C2 | Capacitor_SMD:C_0603_1608Metric | C19666 | 2 | CL10A475KO8NNNC | basic | 2622319 | 0603 16V X5R
CHG/CAM ON | D2,D3 | LED_SMD:LED_0603_1608Metric | C2286 | 2 | KT-0603R | basic | 3789423 | red
10uF | C5 | Capacitor_SMD:C_0805_2012Metric | C15850 | 1 | CL21A106KAYNNNE | basic | 5193619 | 0805 25V X5R
22uF | C3 | Capacitor_SMD:C_0805_2012Metric | C45783 | 1 | CL21A226MAQNNNE | basic | 4115394 | 0805 25V X5R
4.7uH | L1 | Inductor_SMD:L_0805_2012Metric | C63166 | 1 | MPL2012S4R7MHT | extended | 105458 | Sunlord 0805, 800mA, 250mOhm
MLT-5020 | BZ1 | lc:Buzzer_SMD_MLT5020 | C94598 | 1 | MLT-5020 | extended | 28936 | footprint replaced to match
ESD9L5.0ST5G-N | D5,D6 | lc:D_DFN1006-2 | C316041 | 2 | ESD9L5.0ST5G-N | extended | 405063 | v3q: BORN DFN1006-2 USB ESD, 0.6pF, pad 1 = cathode
B5819W | D1 | Diode_SMD:D_SOD-123 | C8598 | 1 | B5819W SL | basic | 544688 | Changjing; Basic (was MDD Extended)
1N4148WS | D4 | Diode_SMD:D_SOD-323 | C2128 | 1 | 1N4148WS | basic | 2267959 | Changjing SOD-323
ESP32-S3-WROOM-1-N16R8 | U1 | lc:ESP32-S3-WROOM-1 | C2913202 | 1 | ESP32-S3-WROOM-1-N16R8 | extended | 21303 | STANDARD-ONLY: forces JLCPCB Standard PCBA
LS027B7DH01 | J3 | lc:FPC_BXCONN_FC-05B10P21H20 | C23398812 | 1 | FC-05B10P21H20 | extended | 2313 | BXCONN, double-sided contacts, gold; FH12-10S drop-in ($0.14 vs $0.51)
OV2640 DVP | J2 | lc:FPC_BXCONN_FC-05B24P21H20 | C23398820 | 1 | FC-05B24P21H20 | extended | 4147 | BXCONN, double-sided contacts, gold; FH12-24S drop-in ($0.10 vs $0.51). Footprint pads in physical FH12 order
TLV75512PDQNR | U6 | lc:LDO_X2SON-4_1x1_P0.65 | C2867150 | 1 | TLV75512PDQNR | extended | 56 | TI X2SON-4 1x1, DVDD 1.2V; low stock - TECH PUBLIC TPTLV75512PDQNR C55191435 is pin-compatible
TLV75528PDQNR | U5 | lc:LDO_X2SON-4_1x1_P0.65 | C2865384 | 1 | TLV75528PDQNR | extended | 72 | TI X2SON-4 1x1, AVDD 2.8V; low stock - TECH PUBLIC TPTLV75528PDQNR C55191439 is pin-compatible
TLV75533PDQNR | U4 | lc:LDO_X2SON-4_1x1_P0.65 | C2861882 | 1 | TLV75533PDQNR | extended | 2078 | TI X2SON-4 1x1, DOVDD 3.3V
AO3401A | Q1 | Package_TO_SOT_SMD:SOT-23 | C15127 | 1 | AO3401A | basic | 813323 | Alpha & Omega; Basic P-FET (was SI2301 Extended)
AP2112K-3.3 | U10 | Package_TO_SOT_SMD:SOT-23-5 | C51118 | 1 | AP2112K-3.3TRG1 | extended | 40520 | Diodes Inc.
TP4054 | U2 | Package_TO_SOT_SMD:SOT-23-5 | C668215 | 1 | TP4054 | extended | 145104 | UMW; pin-compatible with MCP73831 (was $0.63)
DMG1012UW-7 | Q2 | Package_TO_SOT_SMD:SOT-323_SC-70 | C156390 | 1 | DMG1012UW-7 | extended | 2465 | v3q: Diodes SOT-323 N-FET, Vgs(th) <=1.0V, buzzer driver
74LVC1G14GW | U8 | Package_TO_SOT_SMD:SOT-353_SC-70-5 | C19829653 | 1 | 74LVC1G14GW | extended | 3364 | TECH PUBLIC SC-70-5 (SOT-353)
TPS61222 | U7 | Package_TO_SOT_SMD:SOT-363_SC-70-6 | C116461 | 1 | TPS61222DCKR | extended | 1082
USB-C | J1 | lc:USB_C_ShouHan_TYPE-C-16P-CB0.8-073 | C2906289 | 1 | TYPE-C 16P CB0.8 073 | extended | 30919 | SHOU HAN; mid-mount for 0.8 mm boards, STANDARD-ONLY; shell legs are plated slots (hand-soldered THT)
