ameesme/little-camera/hardware/pcb/fab/cnc/lc_v3q_cnc_assembly.step

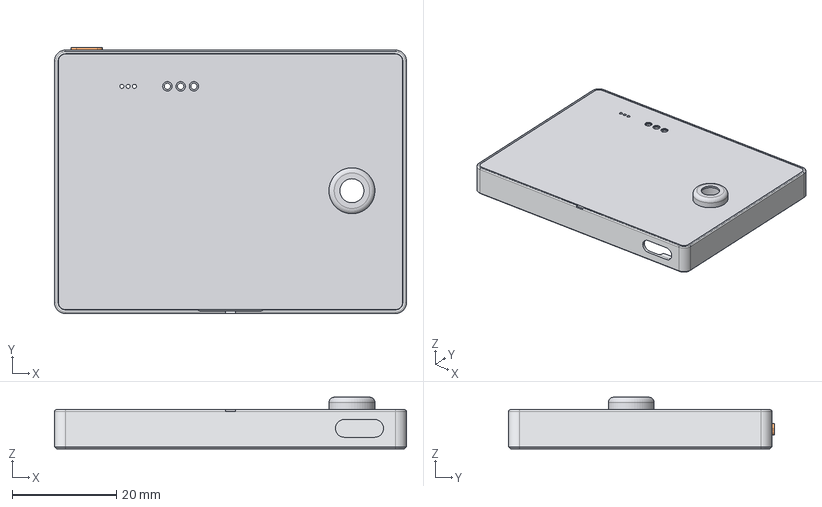
[picture p9: CAD file, 2026-10-27]
hardware/pcb/fab/cnc/lc_v3q_cnc_assembly.step
67.4 x 50.9 x 9.88 mm
top_case
back_plate
shutter_key
