ameesme/little-camera/hardware/pcb/fab/cnc/lc_v3q_cnc_top_case.step

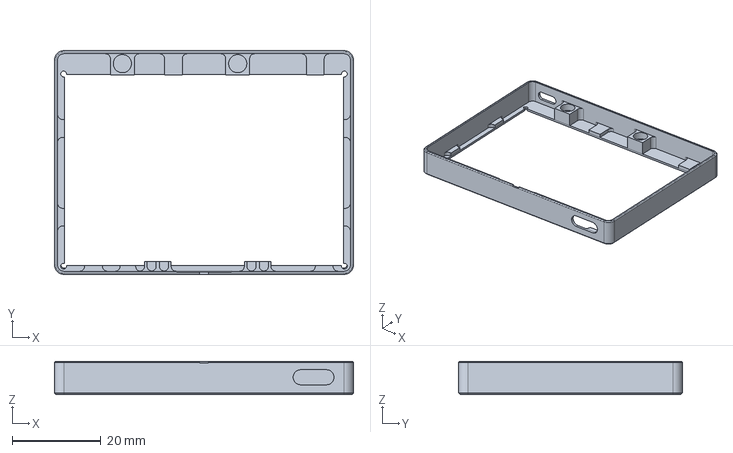
[picture p10: CAD file, 2026-10-27]
hardware/pcb/fab/cnc/lc_v3q_cnc_top_case.step
67.4 x 50.4 x 7.48 mm
