ameesme/little-camera/hardware/pcb/fab/cnc/lc_v3q_cnc_back_plate.step

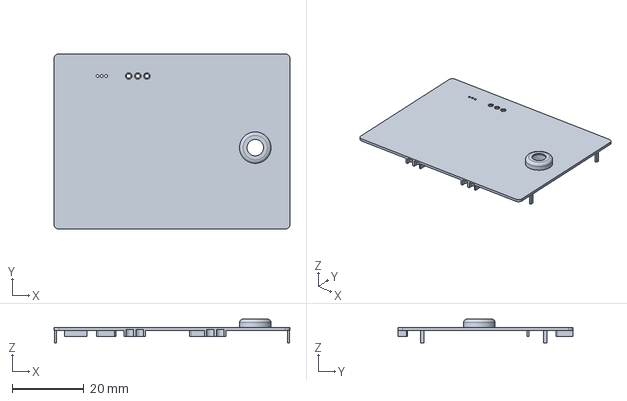
[picture p11: CAD file, 2026-10-27]
hardware/pcb/fab/cnc/lc_v3q_cnc_back_plate.step
65.9 x 48.9 x 6.70 mm
