ameesme/little-camera/hardware/pcb/fab/cnc/lc_v3q_cnc_shutter_key.step

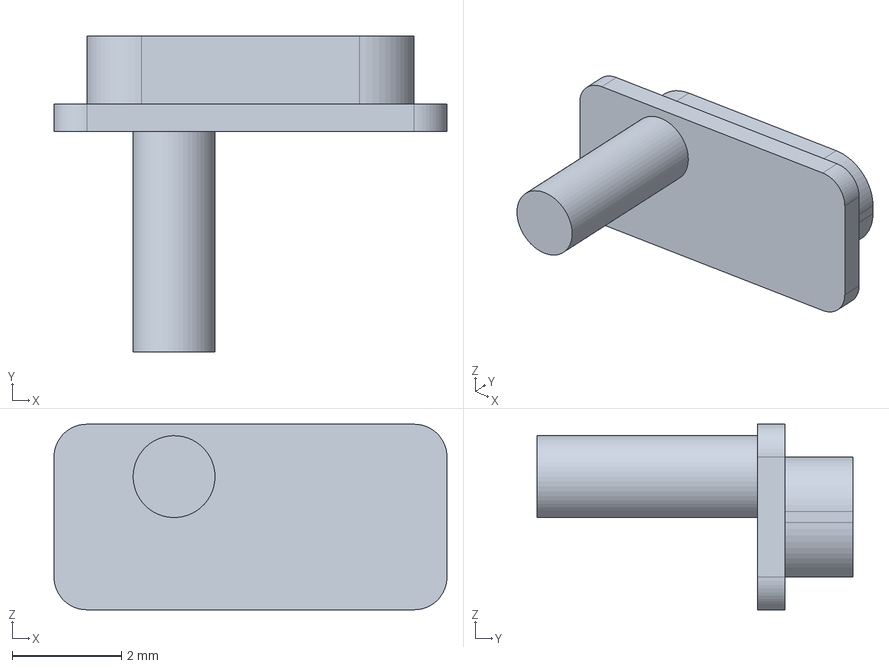
[picture p12: CAD file, 2026-10-27]
hardware/pcb/fab/cnc/lc_v3q_cnc_shutter_key.step
7.20 x 5.79 x 3.40 mm
