ameesme/little-camera/(list of files, drawings)

Other design files:
hardware/pcb/gen/little_camera_v3_fanout.dsn
hardware/pcb/gen/v3a.dsn
