ameesme/little-camera/hardware/pcb/little_camera.kicad_pcb

## KiCad design hardware/pcb/little_camera.kicad_pcb (2026-10-27)

Schematic: little_camera.kicad_sch

Parts:
BZ1: MLT-5020; Buzzer_SMD_MLT5020
C1, C2: 4.7uF; C_0603_1608Metric
C3: 22uF; C_0805_2012Metric
C4, C8, C10, C12, C22, C23: 1uF; C_0402_1005Metric
C5: 10uF; C_0805_2012Metric
C6, C7, C14, C19, C20, C24: 100nF; C_0402_1005Metric
C9, C11, C13: 2.2uF; C_0603_1608Metric
C16, C17, C21: 10uF; C_0603_1608Metric
C18: 1uF; C_0603_1608Metric
D1: B5819W; D_SOD-123
D2: CHG; LED_0603_1608Metric
D3: CAM ON; LED_0603_1608Metric
D4: 1N4148WS; D_SOD-323
D5, D6: ESD9L5.0ST5G-N; D_DFN1006-2
FLG1, FLG2, FLG3, FLG5: PWR_FLAG
J1: USB-C; USB_C_ShouHan_TYPE-C-16P-CB0.8-073
J2: OV2640 DVP; FPC_BXCONN_FC-05B24P21H20
J3: LS027B7DH01; FPC_BXCONN_FC-05B10P21H20
J4: DOCK / I2C; TestPads_Dock3_P2.54
J5: BAT; BAT_Pads_Small
L1: 4.7uH; L_0805_2012Metric
Q1: AO3401A; SOT-23
Q2: DMG1012UW-7; SOT-323_SC-70
R1, R2, R5: 5.1k; R_0402_1005Metric
R3, R12, R28, R31: 100k; R_0402_1005Metric
R4, R34, R35: 1M; R_0402_1005Metric
R6, R27: 1k; R_0402_1005Metric
R7: 47k; R_0402_1005Metric
R8: 33k; R_0402_1005Metric
R9: 51k; R_0402_1005Metric
R10, R11, R15, R16: 4.7k; R_0402_1005Metric
R13, R14, R20, R21, R26: 10k; R_0402_1005Metric
R17: 2.2k; R_0402_1005Metric
R19, R33: 200k; R_0402_1005Metric
R22, R23, R24, R25: 330R; R_0402_1005Metric
SW1: D2MQ-1-TR; SW_Omron_D2MQ-1-TR
SW2: BOOT; SW_Pads_Short
SW3: RESET; SW_Pads_Short
U1: ESP32-S3-WROOM-1-N16R8; ESP32-S3-WROOM-1
U2: TP4054; SOT-23-5
U4: TLV75533PDQNR; LDO_X2SON-4_1x1_P0.65
U5: TLV75528PDQNR; LDO_X2SON-4_1x1_P0.65
U6: TLV75512PDQNR; LDO_X2SON-4_1x1_P0.65
U7: TPS61222; SOT-363_SC-70-6
U8: 74LVC1G14GW; SOT-353_SC-70-5
U10: AP2112K-3.3; SOT-23-5

Connections:
+3V3: BZ1.1 (+), C5.1, C19.1, C20.1, C21.1, C22.1, D4.1 (K), J4.3, R10.1, R11.1, R20.1, R21.1, R26.1, U1.2 (3V3), U8.5 (VCC), U10.5 (VOUT)
AVDD: C11.1, J2.4, U5.1 (OUT)
BOOT: R21.2, SW2.1, U1.27 (IO0)
BUZZ: R27.1, U1.16 (IO46)
BUZZ_DRV: BZ1.2 (-), D4.2 (A), Q2.3 (D)
BUZZ_G: Q2.1 (G), R27.2, R28.1
CAM_D0: J2.19, U1.32 (IO39)
CAM_D1: J2.21, U1.34 (IO41)
CAM_D2: J2.22, U1.35 (IO42)
CAM_D3: J2.20, U1.33 (IO40)
CAM_D4: J2.18, U1.31 (IO38)
CAM_D5: J2.16, U1.24 (IO47)
CAM_D6: J2.14, U1.23 (IO21)
CAM_D7: J2.12, U1.21 (IO13)
CAM_EN: R12.1, U1.26 (IO45), U4.3 (EN), U5.3 (EN), U6.3 (EN)
CAM_HREF: J2.9, U1.20 (IO12)
CAM_PCLK: J2.17, U1.25 (IO48)
CAM_PWDN: J2.8, R13.2, U1.19 (IO11)
CAM_RESET: C14.1, J2.6, R14.2, U1.17 (IO9)
CAM_SIOC: J2.5, R15.2, U1.12 (IO8)
CAM_SIOD: J2.3, R16.2, U1.11 (IO18)
CAM_VSYNC: J2.7, U1.18 (IO10)
CAM_XCLK: J2.13, U1.22 (IO14)
CC1: J1.A5 (CC1), R1.1
CC2: J1.B5 (CC2), R2.1
CHG_PROG: R5.1, U2.5 (PROG)
CHG_STAT: R31.2, R33.1, U1.10 (IO17)
CHG_STAT_OD: D2.1 (K), R7.2, R31.1, U2.1 (STAT)
DOVDD: C9.1, J2.11, R13.1, R14.1, R15.1, R16.1, R17.1, U4.1 (OUT)
DVDD: C13.1, J2.10, U6.1 (OUT)
EXTCOMIN: J3.4, R19.1, U8.4
GND: C1.2, C2.2, C3.2, C4.2, C5.2, C6.2, C7.2, C8.2, C9.2, C10.2, C11.2, C12.2, C13.2, C14.2, C16.2, C17.2, C18.2, C19.2, C20.2, C21.2, C22.2, C23.2, C24.2, D3.1 (K), D5.2 (A), D6.2 (A), FLG1.1, J1.A1 (GND), J1.A12 (GND), J1.B1 (GND), J1.B12 (GND), J1.SH (SHIELD), J2.2, J2.15, J3.9, J3.10, J4.1, J4.6, J5.2, Q2.2 (S), R1.2, R2.2, R4.2, R5.2, R9.2, R12.2, R28.2, R33.2, R35.2, SW1.2, SW2.2, SW3.2, U1.1 (GND), U1.40 (GND), U1.41 (GND), U2.2 (V_{SS}), U4.2 (GND), U4.5 (EP), U5.2 (GND), U5.5 (EP), U6.2 (GND), U6.5 (EP), U7.3 (GND), U8.3 (GND), U10.2 (GND)
LCD_DISP: R25.1, U1.7 (IO7)
LCD_DISP_P: J3.5, R25.2
LCD_SCLK: R22.1, U1.4 (IO4)
LCD_SCLK_P: J3.1, R22.2
LCD_SCS: R24.1, U1.6 (IO6)
LCD_SCS_P: J3.3, R24.2
LCD_SI: R23.1, U1.5 (IO5)
LCD_SI_P: J3.2, R23.2
LED_CAM: D3.2 (A), R17.2
LED_CHG: D2.2 (A), R6.2
MCU_EN: C23.1, R20.2, SW3.1, U1.3 (EN)
OSC_RC: C18.1, R19.2, U8.2
PFET_GATE: Q1.1 (G), R3.2, R4.1
SCL_SYS: J4.5, R11.2, U1.38 (IO2)
SDA_SYS: J4.4, R10.2, U1.39 (IO1)
SHUTTER: C24.1, R26.2, SW1.1, U1.36 (RXD0)
SPARE_1: J4.2, U1.37 (TXD0)
SW_L: FLG5.1, L1.2, U7.5 (L)
USB_DM: D6.1 (K), J1.A7 (D-), J1.B7 (D-), U1.13 (USB_D-)
USB_DP: D5.1 (K), J1.A6 (D+), J1.B6 (D+), U1.14 (USB_D+)
VBAT: C2.1, C16.1, J5.1, L1.1, Q1.3 (D), R34.1, U2.3 (V_{BAT}), U7.1 (VIN), U7.6 (EN)
VBAT_ADC: C7.1, R34.2, R35.1, U1.15 (IO3)
VBUS: C1.1, D1.2 (A), FLG2.1, J1.A4 (VBUS), J1.A9 (VBUS), J1.B4 (VBUS), J1.B9 (VBUS), R3.1, R6.1, R7.1, R8.1, U2.4 (V_{DD})
VBUS_SENSE: C6.1, R8.2, R9.1, U1.9 (IO16)
VDISP: C17.1, J3.6, J3.7, J3.8, U7.2 (FB), U7.4 (VOUT)
VSYS: C3.1, C4.1, C8.1, C10.1, C12.1, D1.1 (K), FLG3.1, Q1.2 (S), U4.4 (IN), U5.4 (IN), U6.4 (IN), U10.1 (VIN), U10.3 (EN)

Notes on the sheet:
USB-C input
power path, charger, 3V3
battery sense + system I2C
camera rails + DVP connector
Sharp panel, 5V boost, hardware VCOM
shutter, buzzer, spare IO
ESP32-S3 support
ESP32-S3-WROOM-1-N16R8

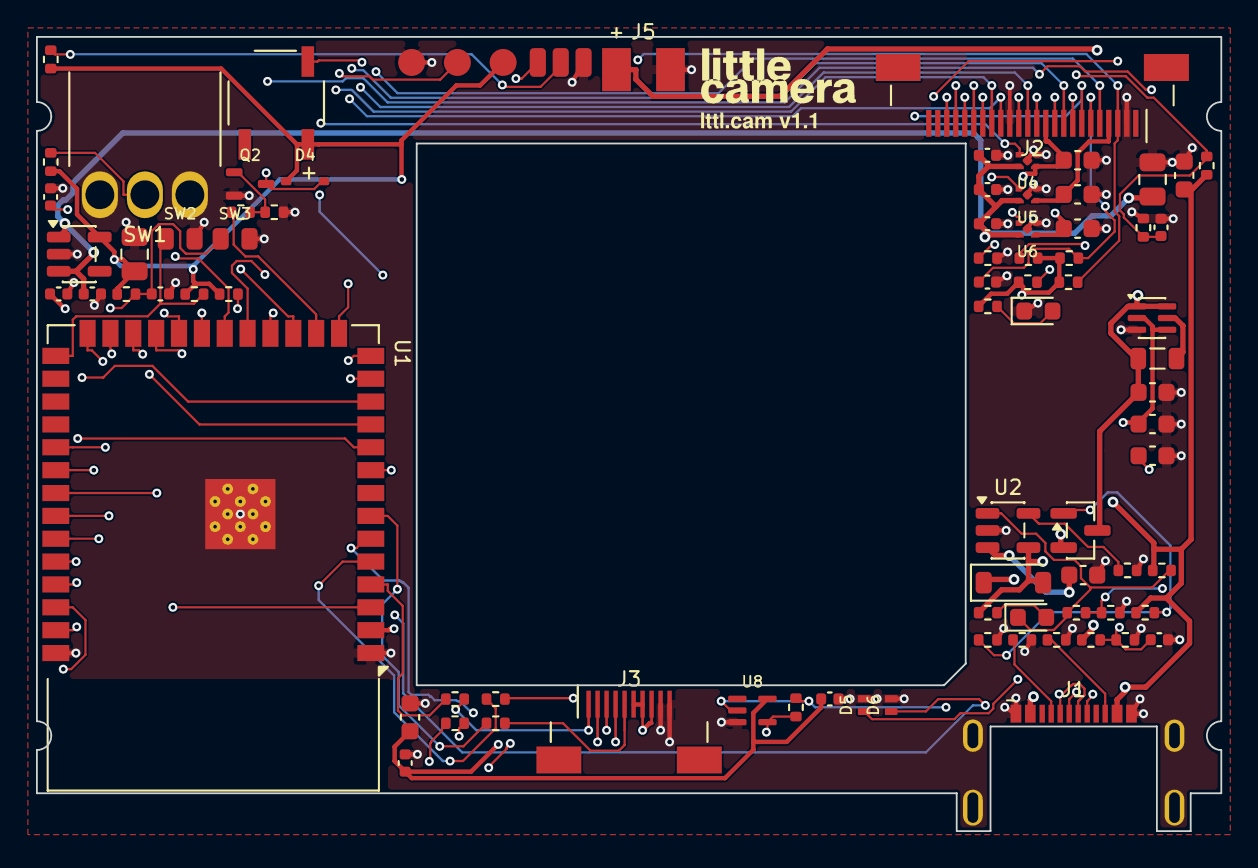
[picture p15: board little_camera.kicad_pcb from above]

Board: 4 copper layers, 65.8 x 44.1 mm, 83 parts (0 on the bottom side), 58 nets.

Other parts of the board:
MECH1: LS027B7DH01 panel; MECH_LS027B7DH01
MECH2: LP403030 cell; MECH_LP552035
MECH3: OV2640 module (mock-up); MECH_OV2640_CAM
