ameesme/little-camera/firmware/src/display.h

#pragma once

#include <Arduino.h>
#include "ui.h"

namespace Display {

// Display dimensions
constexpr int WIDTH = 400;
constexpr int HEIGHT = 240;
constexpr int BYTES_PER_LINE = WIDTH / 8;  // 50 bytes

// The photo, dithered to 1-bit and cached so the save slide can re-blit it at a
// new offset each frame instead of re-dithering. Packed MSB-first, bit set =
// white, no padding.
constexpr int PHOTO_WIDTH = 320;
constexpr int PHOTO_HEIGHT = HEIGHT;
constexpr int PHOTO_BYTES = PHOTO_WIDTH / 8;  // 40 bytes per row

void init(uint8_t sclk, uint8_t mosi, uint8_t cs, uint8_t disp);
void clear();
void fillPattern(uint8_t pattern);
void drawTestPattern();
void drawSplash();
// The pairing screen: one big line (the six digits, or how it ended) scaled to
// fit, with an optional hint under it. Its own screen because a toast is both
// too small for a code and too easy for another toast to paint over.
void drawPairing(const char* big, const char* hint = nullptr);
// The firmware update screen (docs/protocol.md §3.7): a line saying what is
// happening, a progress bar when there is something to measure (percent < 0
// leaves it out), and an optional hint under it. Like pairing, a screen rather
// than a toast: it holds the panel for minutes.
// `mark` is the 24x24 icon above the line, blown up; nullptr is the sparkles
// the phone shows beside it. A failure passes the alert mark instead.
void drawUpdate(const char* line, int percent, const char* hint = nullptr, const uint8_t* mark = nullptr);
// Repaint only the progress bar of the update screen already up, and push only
// its rows. Cheap enough to follow every percent; a no-op if the last
// drawUpdate() had no bar.
void drawUpdateProgress(int percent);
// The sleep face for a mood (docs/mood.md; bands as Chirp::band) and one of
// two breath frames. drawSleep() alone is the happy face at rest.
// faceOnly pushes just the face rows (a breath frame on a face already up).
// status is a debug line drawn bottom-left, outside the face rows; the caller
// formats it, so this stays free of anything it would need hardware to read.
void drawSleep(uint8_t happiness = 255, bool breathIn = false, bool faceOnly = false,
               const char* status = nullptr);
// Move the pal on the sleep face already up to its idle animation at `ms`,
// sending only its rows, and only when the frame changed: cheap enough to call
// every loop. Later sleep faces keep that frame; animateSleepPal(0) is the rest
// pose, for a face that will sit unanimated through light sleep.
void animateSleepPal(uint32_t ms);
// The completed wake hold: mood-specific awake eyes on the inverted sleep screen.
void drawAwake(uint8_t happiness = 255);
// Wake handoff: the full face exits upward, then its miniature enters the sidebar downward.
void drawWakeExit(uint8_t happiness, float t);
// Supply a first camera frame at t=0, then nullptr to reuse its cached dither.
void drawWakeEnter(const uint8_t* grayscale, int srcWidth, int srcHeight, float t);
void drawViewfinder(const uint8_t* grayscale, int srcWidth, int srcHeight);
#ifdef LC_PROFILE_VIEWFINDER
struct ViewfinderTiming { uint32_t ditherUs, layoutUs, spiUs, photoUs, sidebarUs, overlayUs; };
ViewfinderTiming viewfinderTiming();
#endif
void drawCapture(const uint8_t* grayscale, int srcWidth, int srcHeight);  // Floyd-Steinberg dither
// Post-capture save prompt: photo shifts left, send/trash buttons take the
// right column. Not the (future) gallery — this only acts on the frame you
// just shot.
void drawSave(const uint8_t* grayscale, int srcWidth, int srcHeight);
// One frame of the capture -> save slide. t=0 reproduces drawCapture(), t=1
// reproduces drawSave(). Reuses the photo dithered by the last drawCapture()
// call rather than re-dithering, so it must follow one.
void drawSaveTransition(float t);
// Invert the visible hold button left-to-right after 200ms; heldMs=0 cancels an unfinished hold.
void drawHoldProgress(uint32_t heldMs, uint32_t thresholdMs);
void drawWakeProgress(uint32_t heldMs, uint32_t thresholdMs);
void clearWakeProgress();
// Keep the triggered button inverted across redraws and slides until it leaves the screen.
void completeHold();
// A short, non-blocking inversion for the press action chosen by an early release.
void flashPress();
// One frame of the save -> viewfinder slide out, same t convention. Bayer-
// dithers a live frame instead of reusing the capture, so the viewfinder can
// come back to life while the columns are still moving. Pass nullptr to keep
// showing whatever was last dithered.
void drawDismissTransition(const uint8_t* grayscale, int srcWidth, int srcHeight, float t);

// Gallery: one stored photo in the save-layout geometry (card flush left) with
// a browse column on the right: next (press) with the position counter, and
// back (hold). `bits` is panel polarity — set bit = white — and exactly
// PHOTO_BYTES * PHOTO_HEIGHT bytes, i.e. what Storage::loadPhoto() produces.
// Display knows nothing about files, which is what lets the preview tool hand
// it any bitmap. index is 0-based, total >= 1.
void drawGallery(const uint8_t* bits, int index, int total);
// One frame of the viewfinder -> gallery slide, same t convention as
// drawSaveTransition: t=0 has the photo in the viewfinder position with the
// sidebar up, t=1 reproduces drawGallery(). Same `bits` contract.
void drawGalleryTransition(const uint8_t* bits, int index, int total, float t);
// One frame of the gallery -> viewfinder slide out, same convention as
// drawDismissTransition: Bayer-dithers a live frame, or pass nullptr to keep
// showing the gallery photo while the columns move.
void drawGalleryDismissTransition(const uint8_t* grayscale, int srcWidth, int srcHeight,
                                  int index, int total, float t);
// Gallery with nothing to show: an empty card and only the back button.
void drawGalleryEmpty();

// System menu: a full-screen list of items with the selected row inverted.
// items is an array of count labels; selected is 0-based. The right column
// has next (press) and select (hold) buttons, like the gallery.
void drawMenu(const char* const* items, int count, int selected);
// Move the selection from `prev` to `next` without redrawing the whole screen.
void drawMenuSelect(const char* const* items, int count, int prev, int next);

// Diagnostics: a full screen of key-value lines. Each line is "label: value".
struct DiagLine { const char* label; const char* value; };
void drawDiagnostics(const DiagLine* lines, int count);

// Share blog: shows the short code big, with "lttl.cam" as the context.
void drawShareBlog(const char* code, const char* hint);

// True while a toast is on screen and not yet expired. Static screens (the
// gallery) redraw only when this changes; the viewfinder redraws every frame
// anyway.
bool toastVisible();

// The cached 1-bit photo, PHOTO_BYTES * PHOTO_HEIGHT bytes. This is the exact
// bitmap on the panel, so saving it can't disagree with the frame the user
// approved. Only valid until the next draw call re-dithers — in practice that
// means read it while the save screen is up.
const uint8_t* photoBits();
// On v3q the panel's VCOM comes from U8's EXTCOMIN with EXTMODE tied high, so these toggles are a no-op kept for tools/preview; the interval now only paces the sleep face's breath.
constexpr uint32_t VCOM_INTERVAL_MS = 5000;

void refresh();     // Call periodically; toggles VCOM at most once per interval
void toggleVcom();  // Force a VCOM toggle now — used by the sleep keep-alive

// UI state for sidebar
void setBatteryPercent(int percent);  // 0-100
void setBatteryBars(uint8_t bars);   // 1-4, with hysteresis applied by caller
void setCharging(bool charging);
void setUsb(bool usb);
void setShowHints(bool show);
void setFaceBand(uint8_t band);       // 0-3 as Chirp::band: the face the viewfinder sidebar wears
void setPhotoCount(int count);        // Photos on flash (not rendered yet)
void setSignalLevel(UI::SignalLevel level);

// Companion pal (little_camera_pals.h). 0 = none, 1-4 = equipped.
// The sleep face and the viewfinder sidebar draw the equipped pal.
void setPal(uint8_t palId);
// Pal care on the sleep face: life 0-255 for the bar above the pal, the food
// in hand bottom-right, and a tombstone in the pal's place once it has died.
// True while the sleep face on the panel is out of date, i.e. it owes a full frame.
bool setPalCare(uint8_t life, uint8_t food, bool dead);
// What a pal eats, for the toast that says one turned up: "fish", "fly", ...
const char* palFoodName(uint8_t palId);
// Feeding on the sleep face: until PAL_FEED_TOSS_MS one item hops from the
// food badge to the pal, then until PAL_FEED_MS the pal eats, a heart rises and
// the bar grows from `fromLife` to the life last given to setPalCare(). Call
// setPalCare() with the fed state first. `full` sends the whole panel,
// otherwise only the rows from the heart down.
constexpr uint32_t PAL_FEED_TOSS_MS = 420;
constexpr uint32_t PAL_FEED_MS = 1220;
void drawPalFeed(uint8_t happiness, bool breathIn, uint32_t ms, uint8_t fromLife, bool full);
// The "you got a little pal" screen at animation time `ms`: the pal on a
// turning scalloped badge, equip (press) and skip (hold). Mode::PalFound in
// main.cpp draws it once, then animates it with drawPalDialogFrame().
void drawPalDialog(uint8_t palId, uint32_t ms);
// The next animation frame of that screen: redraws and sends only the badge's
// rows, leaving the title, name, buttons and any hold fill as they are.
void drawPalDialogFrame(uint8_t palId, uint32_t ms);
// After equipping: the awake face full screen, the pal sliding in from the left
// (slideT 0-1, already eased) to the bottom-left corner it keeps on the sleep
// face, and "say hi to <name>". `full` sends the whole panel; otherwise only
// the pal's rows, which is all that moves.
void drawPalWelcome(uint8_t happiness, uint8_t palId, float slideT, uint32_t ms, bool full);

// What the phone asked this camera to photograph (docs/protocol.md §3.3
// PROMPT). The viewfinder says so rather than leaving the holder to guess why
// their phone is showing them a card: the sidebar's face block becomes the
// prompt's icon and a standing toast names the shot. Prompt::None is the
// ordinary camera.
enum class Prompt : uint8_t { None = 0, Verification = 1, Selfie = 2 };
void setPrompt(Prompt prompt);
// True while the phone is standing by for a particular photo, which is not an idle camera.
bool promptPending();

// Toast positioning
enum class ToastHAlign { Left, Center, Right };
enum class ToastVAlign { Top, Bottom };

// Show a toast message that persists over viewfinder updates.
// duration_ms: how long to show (0 = indefinite until clearToast)
// inverted: true = white text on black background
void showToast(const char* text, ToastHAlign halign, ToastVAlign valign,
               bool inverted = false, uint32_t duration_ms = 2000);
void clearToast();

}
