ameesme/little-camera/firmware/src/pixelarticons.h

#pragma once

// Pixelarticons - 24x24 pixel icons
// https://github.com/halfmage/pixelarticons
// License: MIT

#include <stdint.h>

// icon_battery_empty: 24x24 pixels
constexpr int ICON_BATTERY_EMPTY_W = 24;
constexpr int ICON_BATTERY_EMPTY_H = 24;
static const uint8_t ICON_BATTERY_EMPTY[] = {
    0x00, 0x00, 0x00,
    0x00, 0x00, 0x00,
    0x00, 0x00, 0x00,
    0x00, 0x00, 0x00,
    0x00, 0x00, 0x00,
    0x0F, 0xFF, 0xF0,
    0x0F, 0xFF, 0xF0,
    0x30, 0x00, 0x30,
    0x30, 0x00, 0x30,
    0x30, 0x00, 0x3C,
    0x30, 0x00, 0x3C,
    0x30, 0x00, 0x3C,
    0x30, 0x00, 0x3C,
    0x30, 0x00, 0x3C,
    0x30, 0x00, 0x3C,
    0x30, 0x00, 0x30,
    0x30, 0x00, 0x30,
    0x0F, 0xFF, 0xF0,
    0x0F, 0xFF, 0xF0,
    0x00, 0x00, 0x00,
    0x00, 0x00, 0x00,
    0x00, 0x00, 0x00,
    0x00, 0x00, 0x00,
    0x00, 0x00, 0x00,
};

// icon_battery_low: 24x24 pixels
constexpr int ICON_BATTERY_LOW_W = 24;
constexpr int ICON_BATTERY_LOW_H = 24;
static const uint8_t ICON_BATTERY_LOW[] = {
    0x00, 0x00, 0x00,
    0x00, 0x00, 0x00,
    0x00, 0x00, 0x00,
    0x00, 0x00, 0x00,
    0x00, 0x00, 0x00,
    0x0F, 0xFF, 0xF0,
    0x0F, 0xFF, 0xF0,
    0x30, 0x00, 0x30,
    0x30, 0x00, 0x30,
    0x33, 0x00, 0x3C,
    0x33, 0x00, 0x3C,
    0x33, 0x00, 0x3C,
    0x33, 0x00, 0x3C,
    0x33, 0x00, 0x3C,
    0x33, 0x00, 0x3C,
    0x30, 0x00, 0x30,
    0x30, 0x00, 0x30,
    0x0F, 0xFF, 0xF0,
    0x0F, 0xFF, 0xF0,
    0x00, 0x00, 0x00,
    0x00, 0x00, 0x00,
    0x00, 0x00, 0x00,
    0x00, 0x00, 0x00,
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
    0x00, 0x7E, 0xCC,
    0x0F, 0x7E, 0xCC,
    0x0F, 0x7E, 0xCC,
    0x3F, 0x7E, 0xCC,
    0x3F, 0x7E, 0xCC,
    0x3F, 0x7E, 0xCC,
    0x3F, 0x7E, 0xCC,
    0x3F, 0x7E, 0xFC,
    0x3F, 0x7E, 0xFC,
    0x00, 0x00, 0x00,
    0x00, 0x00, 0x00,
    0x00, 0x00, 0x00,
    0x00, 0x00, 0x00,
};

// icon_signal_3: 24x24 pixels
constexpr int ICON_SIGNAL_3_W = 24;
constexpr int ICON_SIGNAL_3_H = 24;
static const uint8_t ICON_SIGNAL_3[] = {
    0x00, 0x00, 0x00,
    0x00, 0x00, 0x00,
    0x00, 0x00, 0x00,
    0x00, 0x00, 0x00,
    0x00, 0x00, 0x3C,
    0x00, 0x00, 0x3C,
    0x00, 0x00, 0xFC,
    0x00, 0x00, 0xFC,
    0x00, 0x00, 0xFC,
    0x00, 0x00, 0xFC,
    0x00, 0x1E, 0xFC,
    0x00, 0x1E, 0xFC,
    0x00, 0x7E, 0xFC,
    0x00, 0x7E, 0xFC,
    0x0F, 0x7E, 0xFC,
    0x0F, 0x7E, 0xFC,
    0x3F, 0x7E, 0xFC,
    0x3F, 0x7E, 0xFC,
    0x3F, 0x7E, 0xFC,
    0x3F, 0x7E, 0xFC,
    0x00, 0x00, 0x00,
    0x00, 0x00, 0x00,
    0x00, 0x00, 0x00,
    0x00, 0x00, 0x00,
};
