ameesme/little-camera/firmware/src/spleen_fonts.h

#pragma once

// Spleen bitmap fonts by Frederic Cambus
// https://github.com/fcambus/spleen
// License: BSD-2-Clause

#include <stdint.h>

// spleen6x12 font - 6x12
// Printable ASCII (32-126)

constexpr int SPLEEN6X12_WIDTH = 6;
constexpr int SPLEEN6X12_HEIGHT = 12;
constexpr int SPLEEN6X12_FIRST_CHAR = 32;
constexpr int SPLEEN6X12_LAST_CHAR = 126;

static const uint8_t SPLEEN6X12_DATA[][12] = {
    {0x00, 0x00, 0x00, 0x00, 0x00, 0x00, 0x00, 0x00, 0x00, 0x00, 0x00, 0x00},  // 32: 'space'
    {0x00, 0x20, 0x20, 0x20, 0x20, 0x20, 0x20, 0x00, 0x20, 0x00, 0x00, 0x00},  // 33: '!'
    {0x00, 0x50, 0x50, 0x50, 0x00, 0x00, 0x00, 0x00, 0x00, 0x00, 0x00, 0x00},  // 34: '"'
    {0x00, 0x00, 0x50, 0xF8, 0x50, 0x50, 0x50, 0xF8, 0x50, 0x00, 0x00, 0x00},  // 35: '#'
    {0x20, 0x78, 0xA0, 0xA0, 0x70, 0x28, 0x28, 0x28, 0xF0, 0x20, 0x00, 0x00},  // 36: '$'
    {0x00, 0x08, 0x48, 0x50, 0x10, 0x20, 0x28, 0x48, 0x40, 0x00, 0x00, 0x00},  // 37: '%'
    {0x00, 0x30, 0x48, 0x48, 0x30, 0x60, 0x94, 0x88, 0x74, 0x00, 0x00, 0x00},  // 38: '&'
    {0x00, 0x20, 0x20, 0x20, 0x00, 0x00, 0x00, 0x00, 0x00, 0x00, 0x00, 0x00},  // 39: 'apostrophe'
    {0x18, 0x20, 0x40, 0x40, 0x40, 0x40, 0x40, 0x40, 0x20, 0x18, 0x00, 0x00},  // 40: '('
    {0x60, 0x10, 0x08, 0x08, 0x08, 0x08, 0x08, 0x08, 0x10, 0x60, 0x00, 0x00},  // 41: ')'
    {0x00, 0x00, 0x00, 0x48, 0x30, 0xFC, 0x30, 0x48, 0x00, 0x00, 0x00, 0x00},  // 42: '*'
    {0x00, 0x00, 0x00, 0x20, 0x20, 0xF8, 0x20, 0x20, 0x00, 0x00, 0x00, 0x00},  // 43: '+'
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
    {0x00, 0x00, 0x00, 0x00, 0x00, 0xC6, 0xC6, 0xD6, 0xD6, 0xD6, 0xD6, 0x6E, 0x00, 0x00, 0x00, 0x00},  // 119: 'w'
    {0x00, 0x00, 0x00, 0x00, 0x00, 0xC6, 0x6C, 0x38, 0x38, 0x6C, 0xC6, 0xC6, 0x00, 0x00, 0x00, 0x00},  // 120: 'x'
    {0x00, 0x00, 0x00, 0x00, 0x00, 0xC6, 0xC6, 0xC6, 0xC6, 0xC6, 0xC6, 0x7E, 0x06, 0x06, 0xFC, 0x00},  // 121: 'y'
    {0x00, 0x00, 0x00, 0x00, 0x00, 0xFE, 0x06, 0x0C, 0x18, 0x30, 0x60, 0xFE, 0x00, 0x00, 0x00, 0x00},  // 122: 'z'
    {0x00, 0x0E, 0x18, 0x18, 0x18, 0x18, 0x70, 0x70, 0x18, 0x18, 0x18, 0x18, 0x0E, 0x00, 0x00, 0x00},  // 123: '{'
    {0x00, 0x18, 0x18, 0x18, 0x18, 0x18, 0x18, 0x18, 0x18, 0x18, 0x18, 0x18, 0x18, 0x00, 0x00, 0x00},  // 124: '|'
    {0x00, 0x70, 0x18, 0x18, 0x18, 0x18, 0x0E, 0x0E, 0x18, 0x18, 0x18, 0x18, 0x70, 0x00, 0x00, 0x00},  // 125: '}'
    {0x00, 0x00, 0x00, 0x00, 0x00, 0x00, 0x32, 0x7E, 0x4C, 0x00, 0x00, 0x00, 0x00, 0x00, 0x00, 0x00},  // 126: '~'
};

static inline const uint8_t* spleen8x16_getGlyph(char c) {
    if (c < SPLEEN8X16_FIRST_CHAR || c > SPLEEN8X16_LAST_CHAR) {
        return SPLEEN8X16_DATA[0];  // Return space for out-of-range
    }
    return SPLEEN8X16_DATA[c - SPLEEN8X16_FIRST_CHAR];
}
