ameesme/little-camera/firmware/src/camera.cpp

#include "camera.h"
#include "esp_camera.h"

namespace Camera {

// v3q: OV2640 on J2, pins from the netlist. CAM_Dn is the sensor's Y(n+2), so
// CAM_D0 is the driver's d0 and the array is already in driver order.
constexpr int PIN_CAM_EN    = 45;  // enables U4/U5/U6, R12 pull-down
constexpr int PIN_CAM_PWDN  = 11;
constexpr int PIN_CAM_RESET = 9;   // R14/C14 releases it ~1ms after the rails
constexpr int PIN_CAM_XCLK  = 14;
constexpr int PIN_CAM_SIOD  = 18;
constexpr int PIN_CAM_SIOC  = 8;
constexpr int PIN_CAM_VSYNC = 10;
constexpr int PIN_CAM_HREF  = 12;
constexpr int PIN_CAM_PCLK  = 48;
constexpr int PIN_CAM_D[8]  = {39, 41, 42, 40, 38, 47, 21, 13};

static camera_fb_t* fb = nullptr;
// Consecutive empty frames before the sensor is taken down and brought back.
constexpr int CAPTURE_RETRIES = 5;
static int _failures = 0;

// With CAM_EN low the sensor's rails are gone, so nothing may drive into it:
// a driven pin into a dead rail leaks through the ESD diodes.
static void pinsHighZ() {
    const int pins[] = {PIN_CAM_PWDN, PIN_CAM_RESET, PIN_CAM_XCLK, PIN_CAM_SIOD,
                        PIN_CAM_SIOC, PIN_CAM_VSYNC, PIN_CAM_HREF, PIN_CAM_PCLK};
    for (int p : pins) pinMode(p, INPUT);
    for (int p : PIN_CAM_D) pinMode(p, INPUT);
}

static bool _vflip = false;
static bool _hmirror = false;
// Until the console says otherwise, the sensor decides which way it is mounted.
static bool _flipChosen = false;

void setFlip(bool vflip, bool hmirror) {
    _vflip = vflip;
    _hmirror = hmirror;
    _flipChosen = true;
    sensor_t* s = esp_camera_sensor_get();
    if (!s) return;
    s->set_vflip(s, vflip ? 1 : 0);
    s->set_hmirror(s, hmirror ? 1 : 0);
}

bool flippedVertically() { return _vflip; }
bool mirrored() { return _hmirror; }

bool init() {
    // Rails first, then the driver. 20ms covers the three LDOs coming up and
    // R14/C14 releasing RESET; the driver probes over SCCB immediately after.
    pinMode(PIN_CAM_EN, OUTPUT);
    digitalWrite(PIN_CAM_EN, HIGH);
    delay(20);

    camera_config_t config = {};
    // CH5/TIMER3: tone() auto-allocates from CH0 upward through Arduino's
    // peripheral manager, which doesn't see channels claimed via ESP-IDF.
    config.ledc_channel = LEDC_CHANNEL_5;
    config.ledc_timer = LEDC_TIMER_3;
    config.pin_d0 = PIN_CAM_D[0];
    config.pin_d1 = PIN_CAM_D[1];
    config.pin_d2 = PIN_CAM_D[2];
    config.pin_d3 = PIN_CAM_D[3];
    config.pin_d4 = PIN_CAM_D[4];
    config.pin_d5 = PIN_CAM_D[5];
    config.pin_d6 = PIN_CAM_D[6];
    config.pin_d7 = PIN_CAM_D[7];
    config.pin_xclk = PIN_CAM_XCLK;
    config.pin_pclk = PIN_CAM_PCLK;
    config.pin_vsync = PIN_CAM_VSYNC;
    config.pin_href = PIN_CAM_HREF;
    config.pin_sccb_sda = PIN_CAM_SIOD;
    config.pin_sccb_scl = PIN_CAM_SIOC;
    config.pin_pwdn = PIN_CAM_PWDN;
    config.pin_reset = PIN_CAM_RESET;
    config.xclk_freq_hz = 20000000;
    config.frame_size = FRAMESIZE_QVGA;      // 320x240
    config.pixel_format = PIXFORMAT_GRAYSCALE;
    config.grab_mode = CAMERA_GRAB_LATEST;
    config.fb_location = CAMERA_FB_IN_DRAM;  // Internal DRAM, not PSRAM
    config.fb_count = 1;

    esp_err_t err = esp_camera_init(&config);
    if (err != ESP_OK) {
        Serial.printf("Camera init failed: 0x%x\n", err);
        // Don't leave the rails up behind a driver that isn't there.
        pinsHighZ();
        digitalWrite(PIN_CAM_EN, LOW);
        return false;
    }

    // Set orientation in sensor registers to avoid per-frame CPU work.
    sensor_t* s = esp_camera_sensor_get();
    if (s) {
        // The OV3660 goes into J2 the other way round from the OV2640, so it starts mirrored.
        if (!_flipChosen) {
            _hmirror = s->id.PID == OV3660_PID;
            _vflip = false;
        }
        s->set_vflip(s, _vflip ? 1 : 0);
        s->set_hmirror(s, _hmirror ? 1 : 0);
        Serial.printf("Camera initialized: sensor PID 0x%02x, vflip %d hmirror %d\n",
                      s->id.PID, _vflip ? 1 : 0, _hmirror ? 1 : 0);
        return true;
    }

    Serial.println("Camera initialized");
    return true;
}

// Takes the sensor's power away, which the previous board could not do at all
// (see docs/camera_standby.md). CAM_EN gates all three camera LDOs, so this
// removes the ~20mA the biased OV2640 used to draw straight through sleep.
// Costs a full re-init before the viewfinder returns on wake.
void deinit() {
    // The driver owns the framebuffer; hand it back before freeing the driver.
    if (fb) {
        esp_camera_fb_return(fb);
        fb = nullptr;
    }

    esp_err_t err = esp_camera_deinit();
    if (err != ESP_OK) {
        Serial.printf("Camera deinit failed: 0x%x\n", err);
    }

    // Order matters: stop driving the pins before the rails go, not after.
    pinsHighZ();
    digitalWrite(PIN_CAM_EN, LOW);
}

uint8_t* capture() {
    // Return previous framebuffer if any
    if (fb) {
        esp_camera_fb_return(fb);
        fb = nullptr;
    }

    fb = esp_camera_fb_get();
    if (!fb) {
        // An OV3660 that has lost sync returns nothing for every frame from then on, and the
        // screen goes on asking: the shutter stops working until someone pulls the battery.
        // Cutting the rails is the only reset the sensor answers to, so take the whole module
        // down and bring it back. A handful of tries first, because one dropped frame is normal.
        if (++_failures < CAPTURE_RETRIES) {
            Serial.println("Camera capture failed");
            return nullptr;
        }
        Serial.printf("Camera capture failed %d times; power-cycling the sensor\n", _failures);
        _failures = 0;
        deinit();
        delay(50);
        if (!init()) return nullptr;
        fb = esp_camera_fb_get();
        if (!fb) return nullptr;
    }

    _failures = 0;
    return fb->buf;
}

}
