ameesme/little-camera/firmware/src/mood_store.h

#pragma once

#include <Arduino.h>

#include "mood.h"

// The mood's NVS home: one versioned blob under Preferences("mood"), plus the
// timezone the phone sent. Writes happen on a photo, on a chirp, on a clock
// change, a new day's schedule and every 15 minutes otherwise, which is
// on the order of a hundred writes a day at worst — nothing for NVS.
namespace MoodStore {

bool load(Mood::Persisted* out);            // Migrates v1; false if absent or unknown
void save(const Mood::Persisted& p);
bool loadTz(int16_t* tzMin);                // false if the phone never sent one
void saveTz(int16_t tzMin);
bool loadMuteDay(uint32_t* day);           // false if never muted
void saveMuteDay(uint32_t day);
void clearMuteDay();

}
