ameesme/little-camera/(commit log)

2026-09-13 feat: adding light sleep with button wake and sleep screen
2026-09-13 feat: migrating to the Xiao_Shutter carrier, reassigning pins and handling inverted shutter polarity
    [camera.cpp, display.cpp, display.h, main.cpp]
2026-09-13 fix: rotating camera output 180 degrees, sensor mounted upside down on the carrier
    [camera.cpp]
2026-09-13 chore: dropping battery and signal sidebar box, inbox spans full height
2026-09-13 feat: tearing down camera before sleep, waking on timer to keep VCOM flipping
    [camera.cpp, camera.h, display.cpp, display.h, main.cpp]
2026-09-13 feat: wiring review screen into a mode machine, press sends and hold trashes
2026-09-13 chore: moving firmware into firmware/ and laying out the monorepo
    Firmware (platformio.ini, src, tools, artifacts, AGENTS.md) moves verbatim into
    firmware/ so the bridge app, the micro-blog server and shared packages can sit
    beside it. The host preview tool still builds from firmware/tools/preview.
    Adds the root workspace (pnpm), a README with the photo-backup step first, and
    docs/protocol.md + docs/flows.md: the BLE and HTTP contract that the firmware,
    the iOS app and the server are all written from.
    Claude-Session: https://claude.ai/code/session_018Do1eGLFYYJFzp83wMP41s
2026-09-13 chore: adding the mockup's dithered photos as PBM fixtures
    Eight genuine 1-bit 320x240 frames plus the avatar, in the exact byte layout the
    firmware writes, so server and package tests run against real camera output
    rather than synthetic patterns.
    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
2026-09-13 feat(firmware): flash backup tool that reads photos off the device without flashing
    dump_flash.py reads the partition table from the chip, finds the LittleFS
    partition, pulls it with esptool and unpacks it on the host with
    littlefs-python (mklittlefs as a fallback), writing every photo as the original
    .pbm plus a .png for previewing. Works with the firmware that is on the board
    today, so it is the step to run before anything else in this series touches
    the device. The raw partition image is kept alongside as insurance.
    Standard-library PBM/PNG helpers live in pbmpng.py so the tools need nothing
    beyond esptool, littlefs-python and pyserial.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
2026-09-13 feat(firmware): storage read path, sync marks, header timestamps and a kinder ring
    Storage grows the half it never had: list, load, header-only info, chunked raw
    reads, delete, and a synced mark that is nothing more than renaming
    /0007.pbm to /0007s.pbm. Eviction now only ever removes synced photos and
    refuses (full, sync first) rather than destroy a photo nobody holds a copy of —
    the original ring's policy made sense only while no export existed.
    Every new file carries a header comment with the boot counter, millis() and
    the unix time if the clock has been set, so photos can be dated later by the
    phone. Older headers still parse. pbm_header.h, crc32.h, sha256.h and
    shortcode.h are Arduin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
    [Arduino.h, console.cpp, console.h, crc32.h]
2026-09-13 feat(firmware): gallery mode, hold in the viewfinder to browse stored photos
    Hold the shutter 700ms in the viewfinder and the frozen capture gives way to
    the gallery: the newest photo on flash in the save-screen geometry, with a
    browse column showing the position (3/12, press = next, wraps) and back
    (hold). The shutter still fires on the press edge — grab on press, commit on
    release — so a normal tap is pixel-identical to before; only a deliberate hold
    trades the shot for the gallery. Both holds fire on their threshold, and both
    screens only act on press edges, so opening never advances and closing never
    shoots.
    Display gets drawGallery(bits, index, total), drawGalleryEmpty() and
    toastV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
2026-09-13 feat(firmware): BLE sync service exposing photos to the bridge app
    A NimBLE peripheral with one service: Info (counts, boot, uptime, clock),
    Secret (16 bytes, encrypted + authenticated read, passkey shown on the panel),
    Control (set time, list, get, ack, delete, abort) and Data (notification
    frames with a sequence number and a CRC-32 trailer). The phone lists unsynced
    photos, pulls each as raw file bytes, uploads it, and ACKs; the ACK renames the
    file to its synced form. Byte layout lives in sync_protocol.h and is pinned by
    the host tests to docs/protocol.md.
    Nothing runs in NimBLE's callbacks except stashing the write; loop() on the
    main thread does storage and display work and surfaces ev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
2026-09-13 feat(ios): bridge app pulling photos over BLE and uploading them as the camera
    SwiftUI + CoreBluetooth + CryptoKit, iOS 17, no packages, generated with
    XcodeGen (ios/project.yml). Black and white only; grey is the 2 px Dither
    checker, the icon is a black square with a white dithered dot.
    Layout: BLE/Protocol.swift is docs/protocol.md in Swift (UUIDs, Info,
    Control encoders, Data/END/LIST decoders, CRC-32, short code with the
    four test vectors). BLE/CameraLink.swift is the one CBCentralManager.
    Sync/SyncEngine.swift is the §3.5 bridge algorithm: SET_TIME, LIST,
    GET with resume-from-offset, seq + length + CRC checks, upload where
    200/201/409 all count as stored, then ACK, then Info again unt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
2026-09-14 feat(pbm): PBM parse, PNG encode and short codes
    Shared TypeScript for the server (and anything else that reads what the
    firmware writes). parsePbm is a tolerant P4 tokenizer that folds the
    firmware's `# boot= up= t=` comment into meta; encodePbm writes the exact
    same header back so files round-trip byte for byte. pbmToPng is a
    hand-rolled 1-bit greyscale PNG (invert bits, filter 0, deflate, inline
    CRC-32) rather than a dependency: the output is identical pixels, ~3 KB,
    and there is nothing native to build. shortCode uses BigInt for the
    40-bit window because JS shifts are 32-bit; it is checked against the
    four vectors in docs/protocol.md.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
2026-09-14 feat(server): schema, camera API, photo ingest and QR verification
    Hono on @hono/node-server with node:sqlite (no native build step; the
    experimental warning is the price). The schema is one migration; SQL
    lives in src/repo/*.ts so a reader can see what runs.
    The camera API follows docs/protocol.md §4 byte for byte. The photo
    pipeline (src/lib/ingest.ts) is separate from the route so the seed and
    the tests push bytes through the same path: parse + hash, dedupe per
    camera, date (camera t > phone hint > upload time, with earlier members
    of an upload-dated batch pushed back a second so index order survives),
    store the file under DATA_DIR/photos/<camera>/<sha>.pbm, then the QR and
    avatar check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
2026-09-14 feat(server): registration, blog, tokens, comments, subscribers and newsletter
    The apex gets registration with an emailed verification link, magic-link
    sign-in, and /me: for an unbound profile the verification picture (a full
    screen QR reading LC:XXXXXX, two statements in the blog's uppercase style,
    the typed-code fallback that only works for a camera that uploaded in the
    last ten minutes), for a bound one the blog URL, subscribers and the
    profile-picture request. The blog on <handle>.<apex> renders the mockup:
    sticky header with avatar and fake battery, subscribe row, articles with
    comments and a comment form, load more. Anonymous visitors see the header,
    the join form and the newest pictur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
2026-09-14 fix(server): links inherit ink, and the README points at seed and fake-camera
    The verification page showed the one colour this project forbids: the
    browser's default blue on a plain link. Links now inherit the ink colour
    everywhere, not only inside .page.
    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
2026-09-14 fix(firmware): only the shutter ends light sleep, and the radio is really off first
    After the BLE service landed the camera woke on its own right after going
    to sleep. The sleep loop treated every wake that was not the VCOM timer as a
    button press, and a BT controller left enabled by the stack teardown keeps
    its own light-sleep wake source armed (wake cause BT, or the sleep call
    rejected with a stale cause). Two changes: Sync::end() forces the controller
    disabled and deinitialised and clears the BT wake source after NimBLE's
    deinit; and the sleep loop now leaves only on a GPIO wake, toggles VCOM on
    the timer, and logs and sleeps through anything else.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
    [main.cpp, sync.cpp]
2026-09-14 chore(firmware): log the reset reason at boot, and an LC_NO_BLE switch for bisecting
    A splash screen where the sleep face was expected is a reset. The first
    boot line now says which kind (panic, watchdog, brownout, ...), and
    -DLC_NO_BLE builds without the radio so a Bluetooth cause can be told from
    everything else on the sleep path.
    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
    [main.cpp]
2026-09-15 fix(firmware): wind the BLE stack down in order before sleeping
    Going to sleep sometimes panicked with InstrFetchProhibited at PC 0 between
    'Entering sleep mode' and 'Sync: stopped'. stopAdvertising() returns as soon
    as the HCI command is sent; the host task still had the advertising-complete
    GAP event in flight, and deinit(true) had already freed the object it lands
    on. Teardown now disconnects any peer and waits for it, stops advertising,
    yields 100ms to the host task, and only then deinits. The
    esp_sleep_disable_wakeup_source(BT) call is gone: the controller is
    deinitialised by then, so it only produced a confusing error line.
    Clau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
    [sync.cpp]
2026-09-15 feat(firmware): doze before sleeping, panel frozen and radio on, and hold to wake
    The idle timeout now leads to a doze rather than straight to light sleep.
    The screen being left up is redrawn once without the hint toast (the
    gallery stays the gallery, anything else becomes a last live frame) and the
    memory LCD holds it; the camera driver is torn down; the radio keeps
    advertising for 30 s, longer while a connected phone is active. Only then
    does the camera light-sleep with the sleep face. Nothing is drawn during the
    doze except that a pairing code wakes the camera, since someone is reading
    it.
    Waking now takes a one-second hold, from the doze and from light sleep
    alike: a tap in a bag does n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
2026-09-15 fix(firmware): sleep face after 10s with the radio still on, wake on the hold, toasts cleared on every screen switch
    The idle timeout puts the sleep face up at once, as it always did; behind it
    the chip stays awake and keeps advertising for 30s (longer while a phone is
    busy) before light-sleeping. Waking takes a one-second hold and now fires as
    the second completes: the post-wake wait for a release is gone, replaced by
    marking the shutter as already pressed so the hold cannot shoot.
    A timed toast only expires when something re-renders, and the capture and
    save screens are drawn once, so a toast carried across a screen switch stuck
    for good. Every transition clears the toast now, and the sav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
    [main.cpp, sync.cpp, sync.h]
2026-09-15 feat(firmware): an audible wake-up sound, bit-banged so it survives light sleep
    Waking played the same 6ms shutter click, through the LEDC tone task, right
    after light sleep — hard to hear and the least trustworthy moment for that
    peripheral. Wake now plays the ascending ta-da-da from boot, driven by
    digitalWrite and delayMicroseconds alone, in both wake paths (behind the
    sleep face and from real light sleep).
    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
2026-09-15 fix(firmware): the wake-up click plays once the first frame is up
    Back to the shutter click on wake, just later. Played at the moment of the
    hold it was inaudible: the click is a burst of tone() messages, Camera::init()
    then hogs the CPU for a few hundred ms, and by the time the tone task runs the
    closing noTone() is queued right behind the sweep. It now plays after the
    first viewfinder frame is drawn, in both wake paths. The bit-banged melody
    from the previous attempt is gone.
    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
    [audio.cpp, audio.h, main.cpp]
2026-09-15 fix(firmware): bit-bang the click so it is heard after a wake
    A bit-banged square wave was heard straight out of sleep every time; the
    tone()-based click was not, even when played late. So the click keeps its
    sweep and step timing but is now driven by digitalWrite alone, everywhere it
    is used, and the wake-up click plays on the hold itself again. The melodies
    still go through tone(), which works fine once the camera is up.
    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
    [audio.cpp, main.cpp]
2026-09-15 feat(firmware): every click a little brighter or duller than the last
    Each click scales its whole frequency sweep by a random 85-115%, so the
    shape and timing stay the same while the pitch wanders a little, like a
    mechanical shutter.
    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
2026-09-15 feat(firmware): a wider spread for the gallery tick
    Same function as the shutter click, but the light tick is 6ms of 5-9kHz
    where the piezo's resonance flattens pitch differences and a 15% spread
    went unheard. It now varies 70-130% in pitch and 550-900us per step.
    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
2026-09-15 fix(firmware): the gallery tick varies downward only
    The light tick's pitch now ranges 55-100% of the original: the original was
    already the bright end of what sounds good on this piezo.
    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
    [audio.cpp]
2026-09-15 chore(firmware): regular click for entering and leaving the gallery
    Light tick = stepping through photos; regular click = wake, capture and
    screen switches, the gallery included.
    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
2026-09-15 chore(firmware): the gallery tick does not dip as low
    Pitch range 75-100% of the original instead of 55-100%.
    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
2026-09-15 chore(firmware): light tick when leaving the gallery for the camera
    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
2026-09-15 chore(firmware): light tick into the gallery, regular click back to the camera
    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
2026-09-15 docs: describing the camera's mood, its chirps and the sleep face over a week
    The tamagotchi behaviour in one place: happiness from time since the last
    photo, the face losing its smile, the one-hour chirp, attention chirps at
    most twice a day and not at night, and what the sound engine has to sound
    like at each stage. Also what the camera can and cannot know about elapsed
    time without a phone.
    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
2026-09-15 feat(firmware): a procedural chirp engine, happiness in, score out
    chirp.h composes a 1-3 segment score (tones, sweeps, sample-and-hold noise)
    from a happiness level and an xorshift seed: on the A major scale and rising
    when happy, detuned, off-scale, falling and noisy when sad, never longer
    than the 300ms ta-da-da. Audio::playChirp() bit-bangs it like the click so
    it is heard straight out of light sleep.
    The player is a template over an output policy, so tools/chirp renders the
    same timing loops to WAV for listening on a laptop, and tools/hosttest
    measures the played length and pins the invariants per band. audio.cpp is
    now part of make check.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
    [Arduino.h, audio.cpp, audio.h, chirp.h]
2026-09-15 feat(firmware): gallery taps chirp at a random happiness
    A test bed for the mood engine until the scheduler exists: every tap in the
    gallery composes a chirp at a random happiness and logs it to Serial before
    playing, after the repaint so the photo is never late for the sound. The
    light tick it replaces comes back with the scheduler.
    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
    [main.cpp]
2026-09-15 feat(firmware): mood clock and chirp scheduler, host-tested
    mood.h is a pure state machine over a caller-supplied clock: happiness
    255 -> 0 over a week since the last photo, one chirp 55-65 minutes after
    it, then attention chirps from the day mark on, the next one drawn 12-20
    hours after the previous so no 24-hour window holds more than two, deferred
    to the morning when the camera knows the local time. The mood clock runs on
    uptime, resumes from NVS across resets, and once a wall clock and the last
    photo's epoch are both known the epoch difference wins, so powered-off
    time counts. mood_store keeps the 17-byte blob and the timezone in NVS.
    tools/hosttest plays a month through it at the 5-sec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
    [mood.h, mood_store.cpp, mood_store.h]
2026-09-15 feat(firmware): the sleep face follows the mood and breathes
    The face is drawn from 16px blocks instead of the baked bitmap, so it can
    change: a smile while happy, the original dot while content, a flat mouth
    when glum, eyes turned over and a frown when sad, in the same four bands
    as the chirps. A second frame moves the eyes up two pixels and the mouth
    down four for a slow breath. Preview scenes for all five.
    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
2026-09-15 feat(firmware): due chirps from the loop and the sleep tick, taps on the sleep face chirp
    main.cpp owns the mood's clock (esp_timer uptime, the wall clock once a
    phone set it, the stored timezone), its NVS blob and its buzzer. The mood
    is serviced every loop iteration and on every 5-second VCOM wake in light
    sleep; a due chirp plays only on the viewfinder or the sleep face, with the
    button up, nothing else sounding and no transfer running. The sleep face
    breathes on the same tick, face rows only, and is redrawn in full when the
    band moves.
    A tap on the sleeping camera, awake or in light sleep, answers with a chirp
    at a random happiness so a press in a bag is heard for what it was; it does
    n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
    [main.cpp]
2026-09-15 feat(sync): SET_TIME carries the phone's UTC offset
    An optional i16 minutes-east-of-UTC behind the epoch, so the camera knows
    local time for the mood's night rule. Four-byte writes from an older app
    are still accepted. The iOS bridge sends its current timezone.
    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
2026-09-16 feat(firmware): a Pairing mode, and taps chirp in the camera's mood
    The passkey event now switches to Mode::Pairing instead of raising a
    toast, and does it without waking a sleeping camera: pairing needs the
    radio and the panel, not the sensor, so the face comes back afterwards
    with a fresh radio window. The button does nothing while it is up and the
    idle timeout is suspended; the phone's outcome, or a minute, ends it.
    Connecting and transferring no longer say anything on screen. A tap on
    the sleeping camera chirps at the current happiness rather than a random
    one, so it both explains the press and says how the camera is doing.
    Claude-S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
    [main.cpp]
2026-09-20 feat(site): the lttl.cam teaser page
    A single self-contained file: a grey box at roughly the device's dimensions
    floats in a white void, casts a soft shadow, and sleeps. Every few seconds
    it turns over to show the viewfinder or a posted photo, then goes back to
    sleeping. The panels are real frames from the firmware's preview renderer,
    including both breath frames of the sleep face, so the page breathes the
    way the camera does.
    Tokens and type are the micro-blog's. The page is black and white; the only
    greys belong to the device itself.
    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
2026-09-20 feat(site): the device is all screen
    No button, no lens, no status line under it. The panel is 57.6 x 34.56 mm of
    glass with a 3 mm bezel, which makes the whole device 63.6 x 40.6 x 7 mm: a
    slimmer, rounder slab that is almost entirely screen. The glass gets a small
    radius of its own so it does not read as a sticker on a rounded shell, and
    the side faces pull back less so they stop looking bolted on.
    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
2026-09-20 feat(site): headline above the device, and a seamless extruded body
    The statement leads: large, left aligned, three lines, above the visual. At
    display size it drops the blog's wide tracking, which only works small.
    The device now turns gently the whole time it floats, so the full turn on
    each state change reads as more of the same motion rather than something
    switching on. Its body is extruded as a stack of identical rounded
    rectangles instead of six flat faces, which removes the notches where a
    square side used to meet a rounded corner, and the glass gets corners of
    its own. Both headline and device are sized against viewport height too, so
    the pair fits above the fold.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
2026-09-20 feat(site): blank back, centred block, hard line breaks
    The back carries nothing at all now. Headline and device sit in a block
    that shrinks to its contents and is centred on the page, with the text left
    aligned inside it on the same axis as the device. The three lines are hard
    breaks rather than wrapping, so they hold at every width.
    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
2026-09-20 feat(site): a smaller camera with thinner bezels
    The bezel drops from 3 mm to 1.75 mm, which puts the device at 61.1 x 38.1
    x 7 mm and takes the glass nearly to the edge, and the whole object renders
    about a quarter smaller. The glass radius is now the shell's radius less
    the bezel, so the corners stay concentric at the new proportions.
    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
2026-09-20 feat(site): size the composition from one measure
    The block's width now drives everything: the headline is 0.18 of it, the
    camera 0.63, the gap 0.12. The headline factor is chosen so its longest
    line fills the measure exactly, which holds on the Arial fallback too since
    it shares Helvetica's metrics.
    This also fixes the headline being clipped on narrow screens. The block
    sized itself to its contents and was then centred, so when the camera made
    it wider than the viewport it overflowed equally both ways and the left
    edge of every line was cut off. The block can no longer exceed the screen.
    Claude-Session: https://claude.ai/code/session_0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
2026-09-20 feat(site): crisper corners and a small lens on the back
    The shell radius drops from 5 mm to 3.5 mm. The glass radius follows it
    down, staying the shell's radius less the bezel so the curves remain
    concentric. The back is no longer blank: one small lens, about 7 mm across,
    which is the only thing on it.
    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
2026-09-20 fix(site): fit the headline by measuring it, not by predicting it
    Sizing the type from calculated font metrics was wrong on real devices. iOS
    renders Helvetica Neue, whose Bold is a shade wider than the Helvetica and
    Arial the arithmetic assumed, so the longest line overflowed the measure and
    wrapped: the three specified lines became four. A headless browser falling
    back to an Arial-metric font fit, which is why it passed here.
    The lines are now measured in whatever font actually resolved and the size
    set so the widest fills the measure exactly, on load, once fonts settle and
    on resize. Each line is its own non-wrapping block, so three lines stay
    three lines regardless. Verified by forcing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
2026-09-20 feat(site): dither the whole 3D view
    The device is now raymarched as a signed distance field in WebGL and
    thresholded against the firmware's own 4x4 Bayer matrix, so the page
    renders it the same way the camera renders the world. Strictly black and
    white, one dither dot per CSS pixel, which is close to the real panel's
    pixel pitch on a phone.
    It had to stop being CSS to do this. A dither lives on the pixel grid, and
    a CSS pattern rotates and foreshortens with the object, reading as texture
    printed on it rather than as a dithered image. Raymarching also gives
    genuinely round edges, so the 32-slice extrusion that faked them is gone.
    The panel is left unshaded, being 1-bit in life, and its tex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
2026-09-20 feat(site): Amaranth Studio's ground and typeface
    Background is #ddd and the type is PP Neue Montreal, matching
    amaranthstudio.com. The font files are licensed so they are not committed;
    fonts/README.md says where they go, and the stack falls back to Helvetica
    Neue until they are there. The headline fits itself by measurement, so it
    fills the measure in the fallback and re-fits when the real font loads.
    The dither's two levels are now the page's ink and ground rather than black
    and white, so the canvas has no visible edge against the new background.
    The studio's accent is deliberately left out: this project is black and
    white.
    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
2026-09-20 feat(site): set the headline in lower case
    Every heading on amaranthstudio.com is lower case; the capitals here were
    inherited from the micro-blog, where they sit at 10px and are tracked wide.
    At 90px that treatment is wrong and the studio's is right. The headline
    refits itself to the new lines automatically, being measured rather than
    calculated.
    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
2026-09-20 feat(site): lift the composition and enlarge the camera
    The pair sits high on the page rather than vertically centred, so the
    headline leads, and the camera goes from 0.63 of the measure to 0.76.
    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
2026-09-20 feat(site): set the headline on overlapping leading
    Leading goes to 0.72, tight enough that ascenders cross the baseline of the
    line above: the dot of "is" falls into the "a" of "camera". The three
    lines read as one mass rather than three rows.
    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
2026-09-20 feat(site): placing the camera above the headline and filling the viewport
    The object leads and the words caption it, rather than the other way round.
    The markup keeps the h1 first and column-reverse does the flip, so the
    document still opens with its own title and a screen reader meets the words
    before the ornament.
    The page is one screen now. The body is 100dvh and the sheet centres itself
    with margin:auto rather than the body centring it with align-items, which
    clips the top of anything taller than the container: on a window too short for
    the composition it should scroll, not lose its head.
    The measure's height cap becomes svh. The stack is about 1.44 measures tall,
    so that cap is the w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
2026-09-20 chore(site): configuring Vercel to serve site/ as a static directory
    The teaser has no build: one HTML file, two fonts, no dependencies and no
    environment variables. outputDirectory points Vercel at site/ and both
    commands are emptied, so it neither installs the monorepo's pnpm workspace nor
    tries to run its build.
    Config as code rather than dashboard settings, so the deployment is
    reproducible from the repository and a Git-triggered build and a CLI one agree.
    The fonts get a year and immutable: their filenames are their versions, and
    Vercel's static default of must-revalidate re-fetches 125 KB on every visit.
    If the faces are ever re-cut, rename them. index.html keeps the revalidating
    def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
2026-09-20 feat(site): putting the shutter, piezo and lens on the back
    The lens sits at the geometric centre of the back; the L runs from it out
    to the left edge (seen from behind), where the piezo hole is, on the same
    centre line; the shutter is directly above that, in the corner. The two
    arms cannot be the same length -- half the width is more than the device
    is tall -- so the L is not diagonally symmetric; both arms share one
    thickness instead, which is what makes it read as a single shape.
    Top and bottom bezels go from 1.75 mm to 3 mm (61.1 x 40.6 x 7 mm) to give
    the L that height. It is drawn flat with tone and outlines rather than
    raised: an extrusion shares its normal with the panel it stands o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
2026-09-20 feat(site): raising the L on the back and sinking its three parts into it
    The L is real geometry now: a boss standing 1.8 mm proud of the back, in
    the shell's own colour rather than a darker patch of paint. What carries it
    at sixteen dither levels is its broken edge, the contact shading at its
    foot, and the walls of the three wells. The lens, the piezo and the shutter
    lie in its face; none of them stands taller than it.
    Its two arms are one thickness, 11.2 mm, set by the two things that have to
    fit inside them, and each end is closed with a half-circle concentric with
    its part, so the outline follows the lens at one end and the button at the
    other. The outer corner is a tight 1.5 mm; the el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
2026-09-20 fix(site): making every curve on the L one radius
    The arms are capsules of one thickness again, so the cap at the lens, the
    cap at the button and the whole outer corner are arcs of the same 5.6 mm.
    The rounded rectangles that replaced them had a 1.5 mm outer corner, which
    read as a broken shape next to two fully round ends.
    The blend at the elbow drops from 2.1 mm to 0.7 mm as well: at the wider
    setting it pushed a visible lump out of the bottom edge of the foot, which
    is the other half of what looked wrong.
    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
2026-09-20 fix(site): filleting the elbow of the L for real
    The two capsules are unioned exactly now, so the outer corner is a true arc
    of the arm's own radius centred on the piezo -- as round as the outside of
    an arm this thick can be -- and the bottom edge of the foot runs dead
    straight into it.
    The inside of the elbow gets a 4 mm fillet added as its own piece of
    material: the corner square minus the disc that rounds it. That is what the
    smooth min was standing in for, and why the bottom edge had a lump in it;
    at a blend small enough not to show there, the elbow was sharp.
    Claude-Session: https://claude.ai/code/session_018Do1eGLFYYJFzp83wMP41s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
2026-09-20 fix(site): making the elbow fillet an exact distance, not a stuck-on corner
    The fillet was added as a piece of material -- the corner square minus the
    disc that rounds it -- and the square's own edges then read as zero in the
    field. The boss is extruded from that field and its edge is broken by it,
    so a false zero inside the fillet came out as a real crease: a sharp corner
    sitting in the middle of a round.
    Inside the corner square the arc is the only boundary there is, so the
    distance to it is measured directly; everywhere else the two capsules
    answer. The two agree along the square's edges, so the field is continuous
    and the fillet is one unbroken curve.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
2026-09-20 feat(site): taking 6 mm off the body and rounding the glass
    The chin was too thick. The body goes from 54 to 48 mm, which halves the
    band above and below the glass to 6.7 mm, and the panel gets a 1.75 mm
    corner radius -- the width of its own bezel -- because a square-cornered
    panel in a shell this soft reads as a sticker.
    The L keeps its shape exactly; only its arms get shorter, since its left
    end and its top end reach equally far and the top end is what the body has
    to clear. It now sits about 8 mm in from the left side rather than 5.
    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
2026-09-20 feat(site): blending the L into the back instead of stepping it off
    The union with the slab is a smooth one now, so the L grows out of the
    shell on a 1.8 mm fillet running the whole way round its base and the back
    reads as a single moulding rather than a part stuck on. It stands 2.1 mm
    proud rather than 1.8 to leave the blend somewhere to go, and the break on
    its top face widens to 0.9 mm to match.
    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
2026-09-20 feat(site): letting the L be wider than it is tall
    A square L on a body this shape has to stop both arms at the shorter of the
    two, which left the foot 8 mm short of the side. Each arm now runs out to
    the same small margin from its own edge instead -- 3 mm at the side, 1.7 mm
    at the top -- so the L takes the proportion of the back it sits on.
    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
2026-09-20 feat(site): dithering the whole page, and turning sooner the first time
    A second canvas, fixed behind the content, carries a radial gradient from
    the middle of the viewport out and screens it with the same matrix the
    device is drawn with, on the same page-aligned grid. The shader indexes the
    gradient and the grid in page coordinates rather than canvas ones, so its
    canvas has no seam; the origin is re-read every frame because the sheet
    moves under it whenever the headline is refitted.
    Two things had to change for it to hold up. The matrix is the firmware's
    4x4 recursed once to 8x8 -- sixteen levels quantised a window-sized ramp
    into rings -- and the ground is a tone rather than paper, becaus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
2026-09-20 feat(site): white through the middle half, then rings to the corners
    The ground is paper again rather than a tone, and the ramp starts halfway
    to the corners instead of at the centre. An ordered dither lays each new dot
    exactly on the lattice, so a linear ramp bands into evenly spaced rings;
    they are the gradient rather than an artefact of it, which is the same way
    the camera's own pictures are made.
    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
2026-09-21 feat(site): one lens on the back, and an even border round the panel
    The L is gone. The back carries the lens alone, up in the top left, about
    8 mm in from each edge it is near so the whole barrel stays on the flat
    rather than climbing the shell's rounded edge. It keeps the treatment the L
    had: raised 1.3 mm, blended into the back with a smooth union so it grows
    out of the shell, the glass sunk into its face, and no colour of its own.
    Nothing on the back needs height any more, so the chin goes with it. The
    bezel is 3 mm on every side and the body is only as tall as that makes it:
    63.6 x 40.6 x 7 mm, down from 61.1 x 48.
    Claude-Session: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
2026-09-21 fix(site): running the dithered ground under Safari's sliding bars
    The ground canvas was sized to innerHeight, which on iOS is the viewport
    with the bars in it. They slide away over the page rather than reflowing
    it, so the canvas was trimmed the moment they did.
    It is 100lvh now -- already as tall as the window can get, with the bars
    merely uncovering more of it -- which also means nothing is repainted while
    they move. The shader takes the field's size from that canvas rather than
    from the window, so the two still agree.
    Its width is set explicitly as well: a canvas is a replaced element, so with
    width auto and left/right pinned it takes its aspect ratio off the height
    instead of stretchi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
2026-09-21 fix(site): letting the ground run behind Safari's bars
    Two things were stopping it. theme-color filled the status bar and the
    toolbar with #ddd, which is exactly the flat band at both ends of the
    screenshot; without it the bars take what is behind them instead. And the
    ground canvas ended precisely at the viewport edge, so even once the bars
    were see-through there was nothing there to see.
    It now hangs 140px past the top and bottom. That costs nothing -- a fixed
    element scrolls nothing, and the page height is unchanged -- and the
    gradient is still measured on the viewport box, so the composition does not
    shift. The paint loop works in viewport coordinates rather than canvas ones
    so the dith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
2026-09-21 fix(site): making the ground the root background so it reaches the bars
    The flat bands at the ends of the screen were the page background colour,
    and that is the hint: a root background is propagated to the canvas and
    painted over the whole of it, past the viewport in every direction. A fixed
    element, however tall, is not -- which is why the last two attempts changed
    nothing.
    The dither is now drawn into a canvas that is never displayed and handed to
    html as a background-image. It is --bleed larger than the viewport on all
    sides and centred on it, because the painting area is unbounded but the
    positioning area is not: an image the size of the viewport stops exactly
    where the bars begin. Att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
2026-09-21 fix(site): pinning the root box to the large viewport for the ground
    The colour was reaching behind the bars and the image was not, which points
    at the background's positioning area rather than its painting area. Two
    things were sizing that to the short viewport: background-attachment:fixed
    hangs it on the visual viewport, and html{height:100%} is 100% of the short
    one on iOS.
    The attachment goes back to the default, so the positioning area is the
    root's own padding box, and paintVignette() pins that box to the large
    viewport it has just measured. The page still does not scroll -- the box is
    the tallest the window gets -- so the ground stays in the same coordinates
    the shader is given.
    Co-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
2026-09-21 fix(site): opacity .999 on the ground, which is what Safari 26 wanted
    Safari 26 on iOS treats a fixed layer with a solid background differently
    from a translucent one: the opaque one is clipped at the top edge of the
    floating bottom bar, the translucent one is composited separately and covers
    the screen. A canvas full of dots is as opaque as it gets.
    So it was never the viewport. viewport-fit, lvh, theme-color and moving the
    ground onto the root background were all aimed at the wrong thing; anything
    below opacity 1 routes through the compositor and buys the whole screen.
    The ground goes back to being a fixed canvas, which is simpler than the root
    background it had been pushed into, keeps t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
2026-09-21 fix(site): a scroll runway, which is what Safari 26 actually wanted
    At scrollY 0 Safari paints the top status area with the root
    background-color no matter what is drawn there; only once the document has
    a non-zero scroll position does it composite real page pixels behind it.
    That is why nothing so far worked -- the page never scrolled.
    So the page is made exactly one runway taller than it needs to be, the
    shell is pushed down by the same amount, and JS scrolls to it on load. The
    margin and the scroll cancel out, so the first frame is identical. 64px
    below 760px wide, zero above it. body is display:flow-root so the shell's
    top margin stays inside it rather than escaping and adding a second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
2026-09-21 revert(site): back to the one-lens back and the even border
    Undoes the six commits that chased the dithered ground behind mobile
    Safari's bars -- lvh sizing, the bleed, dropping theme-color, the root
    background, pinning the root box, opacity .999 and the scroll runway. None
    of it worked on the device, and each round left the page carrying machinery
    for a problem it never solved.
    site/ is byte for byte cb0a643 again.
    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
2026-09-21 feat(site): a transparent render, no gradient, and the credit below the fold
    Three things, and they lean on each other.
    The device's canvas is a stencil now: where the dither would put paper it
    is left transparent instead of filled, so the render contributes its ink and
    nothing else. Filled, it was an opaque rectangle sitting on top of the film
    -- the white frame around the camera. The film goes back under the sheet
    where it belongs, and now runs straight through the render.
    The vignette is gone, ground canvas and all, to see how the page reads flat.
    That takes the shader's page-space plumbing with it: no uPage, no per-frame
    rect read, and the dither indexes its own canvas again.
    The cred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
2026-09-21 fix(site): the device is solid again, only the void is transparent
    Making the whole canvas a stencil put the film straight through the camera
    as well as around it. The two halves need to differ: where the ray hit
    something the paper level is painted and the canvas is opaque, so nothing
    behind the page shows through the device; where it missed, paper stays
    transparent and only the shadow's ink dots are contributed.
    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
2026-09-21 fix(site): the film spans the document instead of the viewport
    It was position:fixed, which covers the viewport and stops there -- and
    fixed layers are exactly what mobile Safari clips at the edge of its bars,
    where ordinary page content flows behind them without trouble. A video full
    of dots is that kind of layer.
    It is absolute over the whole document now. Its height comes from JS,
    measured off the credit rather than off scrollHeight, since the credit is
    absolutely positioned and the film's own height would otherwise feed back
    into the measurement. Scrolling with the page costs nothing here; there is
    only a screenful and a bit to scroll.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
2026-09-21 chore(site): credit at 120% without its brackets, and a body that holds still
    svh rather than dvh on the body, because dvh tracks the bars as they slide:
    every scroll on a phone changed the body's height, which moved the credit,
    which is what the film measures itself against -- the whole background
    shifted as you scrolled. svh is the viewport at its smallest and never
    changes.
    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
2026-09-21 feat(site): the gradient returns, and the film plays inside the headline
    The dithered ground is back exactly as it was. The film stops covering the
    page and moves into the title.
    There is no way to give text a video for a background, so it is a blend: the
    film fills the title's box, and over it sits the heading with its letters
    black. Lighten keeps the brighter of the two, and the film never gets
    brighter than the paper, so everything that is ground stays ground while
    every letter loses to whatever the film is doing behind it.
    The heading's own background is the dithered ground itself rather than a
    flat fill, handed over as a blob and attached to the viewport so it lands
    dot for dot on the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
2026-09-21 feat(site): a hard block of film with the headline inverted on it
    The other way round from the last go: the film runs at full strength as a
    block behind the headline rather than being clipped to the glyphs, and the
    words are inverted on top of it.
    White letters in difference mode come out as 255 minus whatever the film is
    doing behind each one, so they are always the exact opposite of their own
    backdrop and can never sink into it, however the film moves. Isolate keeps
    that reckoning inside the title, against the film, rather than against the
    ground the title sits on. Which is the page's own rule -- if a design needs
    emphasis, invert -- doing the work.
    The heading no longer needs the ground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
2026-09-21 feat(site): washing the whole page in the film so the paper greys
    The same clip a second time, full page at 12%, just enough that the paper
    reads as a shade rather than a flat fill. A second element and so a second
    decoder -- the price of having the film at two strengths at once.
    It goes under the sheet, so the device's canvas has to let it through or the
    canvas is a clean rectangle in the wash, a pale frame around the camera. The
    canvas is opaque where the ray hit the device and transparent where it
    missed. The void's ink dots are still drawn, so the shadow and the
    vignette's grain survive, and coming from the same page-aligned field as the
    ground underneath they land on exactly the dots a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
2026-09-21 feat(site): letting the headline block down onto the ground
    Misread the last one: it was the text that wanted overlaying, not the page.
    The full-page wash and the transparent void it needed both come out again.
    The title block goes to opacity .8, so the whites come back as a shade of
    grey and the blacks pick up the dither underneath. isolation:isolate is what
    makes that safe -- the difference blend inside happens first, at full
    strength, and only the finished block is faded onto the page.
    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
2026-09-21 feat(site): multiplying the headline block onto the ground
    The white of the words becomes whatever the ground is under them -- its
    grey, its dither, its gradient -- while the block's black stays black.
    isolation:isolate on the same element keeps the inversion inside from taking
    part: the difference blend resolves first, at full strength, and only the
    finished block is multiplied onto the page.
    The sheet loses its z-index for it. A stacking context anywhere between the
    title and the ground traps the blend inside, against nothing; document order
    already paints the sheet after the ground, so the z-index bought nothing.
    Claude-Session: http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
2026-09-21 feat(site): the wash returns, held back over the middle
    The film a second time across the whole page at 14%, with a radial mask that
    keeps it down to about a tenth over the camera and the words and lets it up
    towards the edges. The grain runs everywhere; it just gets out of the way of
    what has to be read.
    The void goes transparent again for it, or the canvas is a clean rectangle
    in the wash -- a pale frame round the camera. The device stays opaque so the
    wash cannot show through it, and the void's ink dots are still drawn, so the
    shadow and the vignette's grain survive and land on the dots already there.
    Claude-Session: https://claude.a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
2026-09-21 feat(site): thresholding both film layers back to two values
    The clip is 1-bit to begin with, but the encode, the chroma subsampling and
    the scale on the way to the screen turn its two levels into a spread -- and
    a spread laid over a dithered ground gives muddy half-tones where there
    should be dots.
    filter: grayscale(1) contrast(2000%) is a threshold. Everything either side
    of mid-grey clamps, so what comes out is black or white and nothing between.
    Grayscale first, because a subsampled encode of grey is not exactly grey.
    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
2026-09-21 chore(site): the wash starts at 60 per cent instead of merely easing off
    Misread the last one as holding it back over the middle rather than keeping
    it off entirely. The mask is nothing out to 60%, where the camera and the
    words live, and climbs to full at the corners.
    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
2026-09-21 revert(site): the wash mask back to holding at a tenth, credit back in flow
    The mask returns to flat at about a tenth out to 60% rather than nothing at
    all -- the grain should run everywhere, it just has to get out of the way of
    what is read.
    The credit comes back up under the headline, in the flow, aligned to the
    same left edge, and the band at top:120% goes. Nothing scrolls now: at every
    width the document is exactly the viewport.
    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
2026-09-21 docs(site): the credit is back in the flow
    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
2026-09-21 feat(site): the credit inverts the ground too
    White letters in difference mode, so the line comes out as the exact
    opposite of what is under it and carries the page's own dots reversed
    rather than a colour of its own -- the same rule the headline runs on.
    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
2026-09-21 feat(site): open graph tags and a card cut from the page itself
    Everything in the head is lower case now, the way the page is set: title,
    description, og and twitter, plus canonical, site_name, locale and the
    image's type, dimensions and alt text.
    media/og.png is a real frame of this page rather than a mock-up -- the same
    ground, the same dither, the same glitched headline, the device held face on
    showing a photo -- at 1200x630 and one device pixel per CSS pixel, because
    the dither is one dot per CSS pixel and scaling it would turn the dots to
    mush. The README has the four lines that reproduce it.
    Also an inline SVG favicon of the device, so there is no second request and
    no 404 for /favic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
2026-09-21 fix(site): the void stops repainting the ground's dots, and a landscape card
    The void was drawing every dot the vignette asks for a second time, on top
    of the wash, where the ground behind draws the same dots underneath it. That
    came out as a darker rectangle exactly the size of the canvas -- the ugly
    background behind the camera. It now contributes only what the ground could
    not have known about: the dots the shadow adds.
    uPage is rounded to integers for it, so the two dither grids fall on the
    same lattice. Half a pixel out and the dots interleave instead of
    coinciding, which doubles the density wherever they overlap.
    The card is landscape now, device left and words right, because a portr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
2026-09-21 feat(site): the cat on the card, a bigger camera and the spec line
    The card was showing the viewfinder because the state loop overwrote
    setScreen a moment after it was set; it is nailed shut for the shot now, so
    the gallery frame with the cat is what gets photographed.
    The device goes from 470 to 540 of measure, which takes the headline down
    from 145px to 134 with it, since the type is fitted to whatever column is
    left. The second line is the spec, one line, scaled to the column, and
    "microblog" becomes "website" there and in the description tags.
    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
2026-09-21 feat(site): spec line, a pre-order button, and the card from a corner
    The credit gives way to the spec line the card already carries, so the page
    and the card say the same thing. Under it, a pre-order button: hard-edged
    where everything else is rounded, greyed with dots rather than a flat tint
    -- one ink dot per four pixels, quarter strength, which leaves the label
    readable where a half-tone checker did not. It does nothing yet and says so
    twice, in the disabled attribute and the cursor.
    The block moves to the top of the viewport rather than the middle, so the
    camera and the headline stay high and the button has room underneath. The
    measure caps at 48svh for it; at 54 the desktop started to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
2026-09-21 feat(site): the button becomes a header, and the card turns the other way
    The pre-order button leaves the stack and sits top right in a header that is
    only a button -- where a site puts its call to action -- at about half its
    old size, solid ink with a paper label, no border. .bar is position:relative
    or the fixed ground canvas paints straight over it.
    And the card had the device turned to the wrong corner. Negative yaw is the
    viewer to the right, not positive: the projection I measured it with labelled
    +x as the viewer's left, which is true from behind and backwards from the
    front.
    Claude-Session: https://claude.ai/code/session_018Do1e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
2026-09-21 chore(site): the block drops back to centre under the header
    Centred in what the header leaves rather than pinned under it, which puts
    the camera and the words a little lower than true centre.
    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
2026-09-21 chore(site): spelling out that the blog comes with the camera
    The spec line said "private picture blog", which reads like a thing you
    still have to go and set up. "included" says it is part of what you buy.
    Same string in the page, the three descriptions and the card.
    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
2026-09-21 chore(site): giving the camera more of the sheet
    --w goes from 0.76 to 0.88 of --sheet, about 15% bigger. The stage's
    min-height is derived from --w, so the void grows with it and nothing
    else moves. Checked for overflow at 360x640, 393x667/852 and 1280x700/900
    -- scrollHeight still equals innerHeight everywhere.
    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
2026-09-21 feat(firmware): the sleep face breathes once a second
    BREATH_MS 5000 -> 1000. At five seconds it read as the panel twitching
    rather than the camera breathing.
    Asleep the breath now sets the light-sleep timer instead of riding the
    VCOM keep-alive, since the keep-alive only has a ceiling and this is well
    inside it -- a static_assert holds that. It costs five times the wakeups:
    ~8ms of CPU and 4.6KB of SPI for the face rows each, roughly +0.2mA on a
    ~0.3mA idle. Estimated, not measured; there is no current sense on this
    board and the period is still one constant.
    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
    [main.cpp]
2026-09-21 Revert "feat(firmware): the sleep face breathes once a second"
    This reverts commit dc7c6b71d8055467b1a6568bd81e8351fe4148aa.
    [main.cpp]
2026-09-21 chore(site): the sleep face breathes once a second
    BREATH_MS 2400 -> 1000. Measured on the page: the two frames alternate at
    1000ms, nine breaths inside the 9s the asleep state holds.
    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
2026-09-22 chore(site): four-week battery life joins the spec line
    Third of four bullets, before the blog. Still one line on the card (535px
    in a 541px column, so the fitter leaves it alone) and two on a phone. The
    card is regenerated here anyway -- it was still showing the camera at the
    old 0.76.
    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
2026-09-22 chore(site): the card's spec line breaks onto two lines
    Broken after the second bullet, so the battery claim opens the second
    line. The break is explicit rather than a natural wrap: the generator
    splits on the bullet and puts the <br> in, which keeps the point the same
    whatever the copy does. nowrap and the shrink-to-fit it needed are gone,
    so the type stays at its own size.
    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
2026-09-22 chore(site): tightening the spec line's leading
    1.55 -> 1.4. That is just under the banded line's own height (1em plus
    twice the .16em of padding), so on the page the two bands meet instead of
    sitting apart and the pair reads as one black block, like the headline
    above it. On the card, where there is no band, it just closes the two
    lines up.
    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
2026-09-22 feat(site): a price badge on the camera's top right corner
    Sixteen points with shallow indents (r42 to r36.5) so it reads as a
    scalloped badge, tips rounded by stroking the path in its own fill with a
    round join rather than by drawing arcs -- one number sets every tip and it
    holds whatever the point count. Ink with the price in paper, like the
    pre-order button.
    The star turns once every 24s; the price is a sibling of the svg rather
    than a child, so it stays upright under its own fixed -9 degree tilt. The
    italic is synthetic: the family ships one upright face here.
    Placed against the stage, not tracked to the device, which turns and bobs
    underneath. Its centre is 0.07w in from the stage's r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
2026-09-22 feat(site): a compact stage, and the badge reads new
    The stage's void goes from 0.26w to 0.14w of extra height around the
    device -- 279px to 242px at phone size, which is the vertical shift the
    bigger camera brought in. The device is centred in that, so its top edge
    moved with it and the badge follows: (0.6377 + k - 0.5995) / 2 down, k
    being the extra height, which is 0.089w now. Checked face on at 393px and
    for overflow at 320, 360, 393 and 430.
    The badge says new instead of the price, and the slant is back as a
    skewX(-9deg) of our own next to the +9 degree tilt -- not font-style,
    which would hand it to the browser's synthetic oblique at about 14
    degrees. Size and spacing as given.
    The ca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
2026-09-22 chore(site): the badge shouts NEW, and stops widening the page
    Caps as asked. The spin moves from the <svg> element to the <path>:
    rotating the element swings its axis-aligned box out to sqrt(2) of its
    width, and on a 393px viewport that poked 2-3px past the edge for part of
    every revolution -- an intermittent horizontal scrollbar on a page that is
    meant not to scroll at all. transform-box:fill-box spins the path about
    its own centre inside a box that never moves. Sampled at four points in
    the turn: nothing overflows now, at 320, 360, 393 or 430.
    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
2026-09-22 feat(site): the composition moves into a rounded box
    Everything that moves -- the ground, the wash and the composition on top
    of them -- is one rounded section now, with an 8px gutter around it
    (--gutter) and a 16px radius (--bento). flex:1 0 auto rather than a
    height, so it fills the first screen and pushes whatever comes next down
    the page instead of shrinking for it. No z-index on it: not a stacking
    context, so the title's blend still reaches the ground inside.
    The header floats on the box, inset by the same gutter, and comes after
    the two full-bleed layers in the markup -- all three are positioned and
    none carries a z-index, so document order is the only thing putting the
    button on top.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
2026-09-22 feat(site): a fixed header, and a rounded card
    .bar goes from absolute in the box to fixed, so it stays put once there is
    enough page to scroll, at twice the gutter on each side -- the box is
    already inset by one, and this leaves the button exactly where an absolute
    bar put it. Fixed also takes it out of the box's overflow:hidden, which is
    what lets it sit over content passing underneath.
    The card stops being full bleed: it keeps the page's 8px gutter and takes
    a gentler 8px corner, overriding --bento alone.
    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
2026-09-22 fix(site): the fixed header stops going under the camera
    .bar is fixed but the sheet is positioned too and comes later in the
    markup, so with neither carrying a z-index document order painted the
    camera and the badge straight over the button as soon as anything
    scrolled under it -- which is the whole reason the bar is fixed at all.
    Nothing overlaps while the page is exactly one screen, which is why this
    did not show up when the bar went fixed; add 600px of content below the
    box and scroll 150px and the button is half covered.
    The bar takes the page's one z-index. Safe there because it is a sibling
    of the sheet, not an ancestor: the stacking context it makes is nowhere
    near the title's blend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
2026-09-22 feat(site): the wash multiplies, so it can only darken
    The clip is thresholded to two values, so at plain opacity a white pixel
    computed 0.86 x ground + 0.14 x 255 = 226 against the page's 221: the
    wash was brighter than the background it is meant to be shading, and it
    washed the ground's dots out on the way. Measured across a background
    strip, the brightest pixel was 208 where the paper is 206.
    Multiplied, white is the identity -- the ground passes through untouched,
    dither and all -- and only the clip's black darkens. It cannot exceed the
    ground by construction rather than by a tuned number: the same strip now
    tops out at exactly 206. The cost is half the signal, the half that used
    to lig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
2026-09-22 feat(site): the wash's white comes down to the paper, no blend needed
    brightness(.867) on the end of the threshold maps the clip's two levels
    to black and 221 -- the paper -- instead of black and 255. A white pixel
    used to composite to 0.86 x ground + 0.14 x 255 = 226 against the page's
    221, brighter than the background it is meant to be shading. A
    paper-valued pixel composites to paper at any opacity, so the ceiling
    holds by construction and the opacity is free to carry the texture: .28
    now, and a background strip measures avg 169, max exactly 206, the same
    numbers the multiply gave.
    No mix-blend-mode anywhere near the video, which is the point -- a
    blended layer over it breaks the page on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
2026-09-22 chore(site): a tighter box corner, and the button keeps its own
    --bento 16px -> 4px. The gutter was already 8px and is unchanged.
    The button's radius stops being calc(--bento / 2): at a 4px box that
    would have computed to 2px, near enough to square that it would stop
    reading as rounded, and 8px is what was asked for there. Literal now.
    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
2026-09-22 chore(site): the box takes the softer corner, the button the tighter
    --bento 4px -> 8px, .pre 8px -> 4px. The gutter is unchanged at 8px. The
    button's radius stays a literal rather than a fraction of the box's: it is
    the tighter corner of the two here, not a proportion of it.
    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
2026-09-22 chore(site): the card goes full bleed again
    --gutter and --bento both to 0 for the card. A share image is cropped and
    letterboxed by whoever displays it, so the page's gutter and rounded
    corners read as a mistake rather than as a frame.
    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
2026-09-22 docs(site): the wash's Safari note says what is actually true
    The paragraph still claimed mix-blend-mode breaks the page on iOS and is
    therefore not used. The opposite is the case: a blend is what makes the
    wash render correctly in WebKit, because a bare video goes to the
    compositor and loses the opacity and the mask on the way. Records how it
    was found (hiding .wash was the only change that made Safari correct) and
    what overlay costs against multiply.
    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
2026-09-22 fix(site): the card's ground covers the whole frame
    The recipe overrides --gutter to 0 to go full bleed, which grows the box,
    but the ground canvas is sized from the box and only repaints on a window
    resize -- so it kept the 8px-gutter size and left 16px of bare paper down
    the right edge and along the bottom. The recipe calls paintVignette()
    alongside sizeGL() now, and og.png is regenerated.
    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
2026-09-22 chore(site): darken and exclusion on the title, and 28-day battery
    Blends as asked. Checked with the film frozen on one frame, or the moving
    clip makes any two renders differ for reasons that have nothing to do
    with the blend: exclusion is bit-identical to difference here (the diff
    is exactly zero), because for a pure white source b + s - 2bs collapses
    to 1 - b, which is what |b - s| gives, and the h1 paints only white
    glyphs. multiply -> darken is what actually moves, and only a little:
    max 30 of 255, mean 0.89, since both are the identity at the extremes and
    part company on mid-greys alone.
    Copy: "4-week battery life" -> "28-day battery", "picture blog" ->
    "photo blog", in the page, the t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
2026-09-22 feat(site): a dithered shadow under the box, and a 16px corner
    --bento 8px -> 16px. The header moves out of the section: it is fixed, so
    it renders in the same place either way, and what holds it above the box
    is its z-index rather than its place in the markup.
    The shadow is its own canvas, fixed behind everything, because the ground
    canvas lives inside the box and cannot paint outside it. A 2D rounded-box
    distance field gives the falloff and the page's own Bayer matrix turns it
    into dots -- a soft box-shadow would have been the one thing here not
    made of dots. Indexed in box coordinates, so its dots line up with the
    ground's however wide the gutter gets. It paints below the box only: the
    l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
2026-09-22 feat(site): beeps joins the spec line, and the card sets it by measure
    Fourth bullet, after the specs and before the offer: three facts, the
    charm, then what you get.
    A fifth item does not fit the card's column in two lines at full size
    however it is cut, so the recipe now takes the type down to the smallest
    size where some bullet split does fit (24px from 25.92), then breaks at
    the LAST split that still fits rather than the one that balances the two
    lines. Balancing was the wrong goal and left a hole after "1-bit
    monochrome": the items are too uneven in length for a balanced pair to
    come out near each other, and a short first line reads as a mistake where
    a short last line is just ragged s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
2026-09-22 chore(site): the title says what the thing is
    <title>, og:title and twitter:title all become "little camera -- a 1-bit
    microblog pocket camera". The teaser line was fine on the page but told a
    tab or a shared link nothing about the product.
    The h1 is untouched: the page still reads "a little camera is coming".
    The image alts are too -- they describe the card, which does still show
    those words.
    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
2026-10-26 feat(firmware): a v3q board self-test, standalone on its own pin map
    Five stages driven by the shutter — display, buzzer, camera, button,
    summary — sharing no code with src/, so a failing board points at the
    hardware and not at the app. Carries the v3q netlist's pin map, which
    until the migration lands is the only place it is written down.
2026-10-26 docs: AGENTS.md describes v3q, and says what src/ has not caught up with
    The carrier is gone, so its pin table, its inverted shutter, its software
    VCOM and its unwired PWDN go with it — git has them if they are ever
    wanted. In their place the v3q map, and a migration section naming the
    four things that change behaviour rather than numbers: the polarity, the
    hardware VCOM, the camera rails that can finally come down, and battery
    sense.
    Corrects the panel's bit order while here. "LSB-first" was only ever half
    true: commands and line addresses are reversed, pixel bytes are not, and
    sending those reversed too mirrors every 8-pixel group — which is what
    the first v3q boot showed.
    Co-Authore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
2026-10-26 feat(firmware): the app moves to the v3q board
    The pin map, and the three things that are not just numbers: the shutter
    reads LOW when pressed now that the switch is wired as drawn, the panel's
    VCOM comes from U8 so the serial bit no longer matters, and the camera
    actually loses power — CAM_EN gates its three rails, with every camera pin
    to high-Z before the rail goes so nothing leaks through an ESD diode into
    a dead sensor.
    The env is v3q on esp32-s3-devkitc-1, pinned to the core selftest/ was
    checked against. That core renamed ledcDetachPin, which the app had never
    been built against; audio.cpp now also parks the buzzer gate LOW on every
    path that stops a sound, because a floating Q2 ga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
2026-10-26 fix(firmware): Serial never waits, and board 1's numbers go on the record
    The app light-sleeps far more than the self-test does and was the one still
    missing setTxTimeoutMs(0). After a sleep the USB-Serial-JTAG is off the bus
    while the host keeps polling it, so the core thinks someone is listening and
    every print blocks for ring space — seconds a line, in the firmware's own
    logging. Dropping the text is the right trade. The blind delay(1000) waiting
    for enumeration becomes a bounded wait, which also returns sooner.
    Board 1 passes, and stays as it is, so its quirks are now firmware's problem
    to know: the camera flex conducts either way up and a reversed one just goes
    quiet, and J5's "+" ma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
2026-10-26 docs: the app runs on v3q, and a sleeping camera is unreachable over USB
    Board 1 took the app on the first flash with no rework. The log says the
    whole chain came up: display on the new pins, LittleFS, identity, mood,
    camera init through CAM_EN, advertising, a shutter wake with the rail
    coming back, and a capture. Forty-five seconds of light sleep passed with
    no self-wake, and prints after a sleep arrived instead of stalling.
    Also learned the hard way while trying to get a second look at it: once the
    camera light-sleeps there is no way in over USB. The port stays enumerated
    and nothing answers — no console, no DTR/RTS reset, esptool gives up. The
    shutter is the only way back, which is wor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
2026-10-26 fix(firmware): every melody after the first click was silent
    Saved, deleted and the sleep melody all fired and none of them were
    audible. audio.cpp took the buzzer pin back from tone() with a bare
    ledcDetach(), but the core's Tone.cpp keeps the attached pin in a static
    of its own and only clears it on noTone() — so tone() stayed convinced
    the pin was attached, skipped ledcAttach(), and wrote a frequency to
    nothing. Only the splash melody worked, because it is the one that runs
    before any click has detached the pin.
2026-10-26 feat(firmware): the camera watches its own battery, and drops the rail
    Three things about the power budget, all debugging aids rather than
    product.
    The sleep face carries a raw millivolt readout, never a percentage: the
    TP4054 cannot be paused, so a reading taken on USB is pulled up by the
    charge current and a percentage would be confidently wrong just when
    someone is watching it. It sits below the face rows so a breath frame
    cannot repaint it, with a 20mV deadband so the last digit does not flap
    a full frame at a time.
    Standby samples go to /debug.log, because the one thing that cannot be
    done to a sleeping camera is read its serial port. Five minutes apart,
    plus one the moment the charge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
2026-10-26 perf(firmware): the breath stops, and PSRAM never comes up
    Two of the three things I set out to do turned out already done, which
    is recorded in AGENTS.md so nobody spends the day on them again: the
    IDF already disables the USB-Serial-JTAG pad inside
    esp_light_sleep_start(), and PSRAM is already put in half-sleep, so it
    was worth tens of microamps rather than the milliamp it looked like.
    What is left is real but modest. The sleep tick runs at 5s for two
    minutes after the face goes up — restarted by a tap, because a tap says
    someone is there — and then stretches to a minute with nothing drawn.
    sampleBattery() is split out of showSleepFace() for it, because
    otherwise stretching the tick w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
2026-10-27 feat(firmware): the phone pushes firmware, the camera keeps a way back
    A firmware update session on the BLE service (docs/protocol.md §3.7): a new
    Update characteristic the phone writes [u32 offset][data] to, three Control
    opcodes around it, and UPDATE_STATUS frames carrying the window that keeps a
    phone from outrunning a camera that writes flash from its main loop.
    The point of the shape is that a half-finished update costs nothing. Bytes go
    to the app slot the camera is *not* running from — default_8MB.csv has two of
    3.3MB and only one was ever used — and the bootloader is pointed at it only
    after every byte arrived, the stream's SHA-256 matched what the phone
    promised, and esp_ota_e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
2026-10-27 feat(server): lttl.cam, a prefix the landing page can sit beside, firmware releases
    The apex root stops being ours. Everything this process answers there moves
    under /api (machines) or /app (people), so a landing page built somewhere else
    can own https://lttl.cam/ and a proxy needs exactly two rules to tell them
    apart. Blogs are untouched: mees.lttl.cam still owns its own root. The two
    prefixes are constants in config.ts and every link and emailed URL goes
    through appUrl()/apiUrl(), so they are written down once.
    Firmware releases (protocol §4.7) arrive as /api/firmware/latest and
    /api/firmware/<hardware>/<version>.bin, unauthenticated because an image is
    not a secret and an open URL is on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
2026-10-27 feat(ios): the bridge carries firmware back to the camera
    Info gains its version-2 tail, so the app knows what the camera runs and
    whether its spare slot has room; the card on the main screen says so and
    offers the release the server published. FirmwareUpdater does the push:
    download over HTTPS, check the digest before a single byte goes over
    Bluetooth, then chunks that each carry their own offset, inside the window the
    camera grants.
    Two kinds of flow control run at once and conflating them is the easy mistake
    — canSendWriteWithoutResponse is this phone's controller having room, the
    camera's window is what its main loop can stage while it writes flash — so the
    app keeps to both. A drop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
2026-10-27 docs: lttl.cam, the prefixes, and how firmware gets to the camera
    protocol.md §3.7 is the new contract — the Update characteristic, the window,
    and the four things that make a half-written image cost nothing. §4.7 is where
    releases come from. The apex is written down as lttl.cam throughout, with the
    landing page owning its root and this server answering under /api and /app.
    firmware/AGENTS.md gets the update rules next to the sleep and radio ones,
    including the two that are easy to undo by accident: the health check must not
    depend on anything a rollback cannot fix, and `ota revert` is the way back
    after a USB upload writes the slot the bootloader is no longer pointed at.
    Co-Authored-B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
2026-10-27 fix(server): the mailbox it prints is under /app like every other page
2026-10-27 docs: lttl.cam can hold the landing page and the blog at once
2026-10-27 refactor(server): a domain layer the routes call, instead of each route having its own copy
    The server had no layer between HTTP and SQL, so the same operation was
    written once per caller: approving a subscriber and welcoming them existed
    four times, update_available twice, redeeming an emailed link twice.
    core/ now holds the five things the product actually does — photos,
    subscribers, linking, firmware, viewers — named after the words the schema
    and the UI already use. Routes parse, call one of those, and render. Pages
    moved out of the route files into views/, so routes/owner.tsx is 262 lines
    of routing instead of 490 of routing, markup and inline JavaScript.
    Comments went from 12% of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
2026-10-27 refactor(ios): three objects instead of one, and stages instead of one long scroll
    AppModel was 432 lines holding the link, the sync, the server, the firmware
    and every piece of UI state, with the same Task/do/catch written five times.
    It is now 90 lines that own three things named after what they are:
    CameraSession is the camera as the phone sees it, Blog is what the server
    says about it, FirmwareUpdate is installed against published. Every server
    call goes through one perform(), so a failure becomes a line on screen in
    exactly one place.
    The UI is staged. AppModel.stage picks setup, linking or ready, and inside
    ready a bar switches between camera, firmware, people and log, so no screen
    sh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
2026-10-27 feat: binding a camera is photographing a QR code, and nothing else
    The typed short-code fallback is gone: its proof of possession was "this
    camera uploaded in the last ten minutes", which an actively-synced camera
    satisfies continuously, so anyone who glimpsed the six characters could
    claim a camera they had never touched. Photographing the code needs the
    camera in hand.
    That one rule makes possession the authority, so it now works on a camera
    that is already bound. Hand the camera on and the new owner photographs
    their own code; the photos already posted stay with the blog that posted
    them, because binding only adopts the ones nobody has claimed.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
2026-10-27 refactor(server): five nouns in core, one file each
    core/ was four nouns and a verb. "linking" described a relation between a
    camera and a blog, neither of which had a module, and "viewers" read like a
    second kind of person next to subscribers when it was really "who is making
    this request".
    Now the five things in the domain each have a file named after them:
    cameras hello, and binding to a blog by photographing its QR code
    blogs registering, signing the owner in, and who is reading
    photos an upload, and comments on one
    subscribers the list, the mail, and redeeming an emailed link
    firmware the releases on disk
    Three flows came out of the routes on the way: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
2026-10-27 feat(firmware): Info v3 carries the battery, the storage and the mood
    The Camera tab in the app needs four things the wire never had. Battery was
    the worst of them: server/src/lib/battery.ts has been inventing a
    deterministic seven-day curve, which the camera could have answered for real
    all along.
    Info v3 adds vbat_mv, battery_percent, used_bytes, total_bytes, happiness and
    mood_elapsed_s, plus usb and charging flags. Rewritten rather than appended
    to, because nothing has shipped.
    power.h owns the only mV-to-percent curve in the repo, carried over from
    selftest rather than invented next to it, and selftest now calls it. Both of
    firmware/AGENTS.md's board-1 lessons are handled: charging su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
2026-10-27 feat(server): real telemetry, an owner feed, and letting a phone in
    The battery indicator has been theatre since it was written — lib/battery.ts
    said so on line 1 — so it is gone, and the camera's own reading takes its
    place. POST /telemetry stores what the phone read off Info v3 as given: the
    percentage is the camera's, nothing here recomputes it, and a blog with no
    reported reading shows no battery rather than a plausible lie.
    The app is about to show a blog's pictures, comments and list, which is a
    person's business, and the camera credential only ever proved a camera. So
    §4.9: the phone asks the owner once by email, and the approval names both the
    camera and the blog. A GET on the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
2026-10-28 feat(site): the camera is a <little-camera> element
    The shader, the screens and the turn come out of index.html into
    camera-element.js, so the iOS app can load the same file instead of a
    second copy of the same device. It stays a classic script because the
    page's own script runs at parse time and needs the element defined
    before it, not deferred after it.
    The four sleeping faces of docs/mood.md are frames now, generated with
    the geometry in firmware/src/display.cpp, and a scene key ending in A
    or B is what makes the element breathe. The canvas fades in once a
    panel is on it, since a textureless device is worse than nothing.
    Claude-Sessi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
2026-10-28 feat(server): a phone can ask for its blog's QR code
    The camera photographs the code to bind itself, so the phone holding a
    freshly made blog needs the same code before any camera has ever seen
    it. 409 once the camera is bound, because by then possession has
    already decided.
    Claude-Session: https://claude.ai/code/session_019Pdysn3U1NfkG48qAP1kZJ
2026-10-28 feat(app): connect a camera, claim or make a blog, then two tabs
    Five stages instead of three. setup picks a camera, firmware offers an
    update once, and then the camera itself decides what comes next: a
    camera that already posts to a blog sends the phone to claim, where
    only that blog's inbox can let it in (§4.9), and one that does not
    sends it to onboarding, where a blog is made or signed into, the
    camera photographs the code off this screen, and takes the picture
    that heads the blog. ready is a blog tab and a camera tab.
    No header, no cards, no rules: every stage is the camera floating on
    the landing page's dithered ground, what it says centred under it, and
    what it asks for on the floor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
2026-10-28 feat(app): a landing page, one question per screen, the camera's own icons
    The app opens on what the camera is, turning through its screens, with
    one way in. Setup shows the camera as a dithered shadow until this
    phone has found one, then the real one fades up and turns. Making a
    blog asks for the name, the address and the handle one screen at a
    time, each with the keyboard already up, because a three-field form on
    a phone is a form.
    The panels are the camera's own: mail, send, images and camera lifted
    out of firmware/src/icons.h rather than drawn again here, and the
    sleeping face follows the mood off Info. Wherever the app can do
    nothing until the owner does something, it says so with a sp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
2026-10-28 feat(app): it is little camera, and it decides what it can decide itself
    One camera in the room is not a choice, so setup connects to it rather
    than asking. An update on a camera with a third of a battery left is
    not a choice either, so it installs itself and the screen only says
    what is happening; a flat one asks for a cable instead. The floor is
    33 %, which is more than the push needs and leaves room for the main
    loop to write flash without browning out.
    The way back out of a step moves to the corner, so the bottom of every
    screen holds one primary action and nothing else. The question a
    screen asks is set at 26 pt, because it is the only thing on the page.
    The code is a card now, inside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
2026-10-28 feat: claim an address while typing it, and say one thing per screen
    Every title is now the same voice: what to do, in the imperative.
    "Pick an address" meant nothing, so the step is "Claim your blog" and
    the address is typed in place, `you` before a fixed `.lttl.cam`,
    prefilled from the name and ticked or crossed as it is typed.
    The server has always refused a taken handle, but only after the whole
    form was filled in. `GET /api/camera/handle` answers while the owner is
    still typing, and a character the address cannot contain no longer
    lands. An email that already has a blog is not an error either: it is
    the sign-in path, so the app goes there instead of complaining.
    Before a camera is fou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
2026-10-28 feat(app): one punctuation rule, a spinner that is not a grey wheel
    Titles take no full stop and no uppercase; sentences take a full stop;
    labels on buttons and spinners take neither. "There it is!" is the one
    exclamation in the app and it has earned it. The blog is a little blog
    wherever the camera is a little camera.
    The system spinner is a grey wheel and there is no grey here, so it is
    eight blocks round a square with three lit, drawn on the same lattice
    as everything else. The firmware line is not a wait, so it sits under
    the progress rule as text, and the way out disappears once the update
    is actually running.
    Pairing has always been the camera showing six numbers nobody can read
    with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
2026-10-28 feat(app): the panel shows what the camera is doing on each screen
    Found means asleep, because that is what a camera that has just woken
    and is waiting looks like. Pairing shows six big X's where the six
    numbers are, so the screen on the phone is a picture of the screen in
    your hand. And the code is photographed, not scanned, so the title
    says so.
    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
2026-10-28 feat(app): the card says whose camera it is, not just the handle
    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
2026-10-28 fix(app): the splash is the intro, so there is nothing to cut to
    On a first launch the cover and the page underneath held the same two
    things at different sizes, and the cross-fade read as a jump. The
    intro now opens as its own launch screen — the wordmark and the camera
    and nothing else — and the line and the button fade up under them a
    second and a half later. Neither the wordmark nor the camera moves,
    and one of the two web views is gone with it.
    Returning owners still get the cover, over a slower fade.
    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
2026-10-28 feat(app): no blog yet means the way in, every launch
    The intro was skipped as soon as a camera was paired, so a phone that
    had found a camera but never finished making a blog opened halfway
    through. It now opens on the way in until a camera and a blog have
    actually found each other, which is remembered on disk so a phone that
    is set up never flashes it. Disconnecting puts it back.
    The wordmark sits at the top of that page and the camera keeps the
    middle, rather than the two moving together.
    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
2026-10-28 fix(app): the panel changes behind the turn, not before it
    Swapping the screen and starting the spin in the same frame gave the
    new screen away before the camera had moved. `turnTo` spins first and
    changes the panel at 45 % of the way round, where the back is to you,
    and the line under it follows on the same clock instead of leading.
    The wordmark comes back down from the status bar.
    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
2026-10-28 feat: the camera arrives first, and a dragged one comes back
    The intro fades the camera up on its own, then the wordmark, the line
    and the button together. The wordmark halves the gap between the
    status bar and the camera, and the camera keeps the middle, by giving
    the space above it and the space below the line the same share.
    Letting go of a dragged camera used to leave it at whatever angle the
    finger stopped at. It eases back to where it was over half a second.
    The canvas is a little taller than the device needs, so a turn no
    longer clips it at the top.
    `-demo <screen>` pinned the stage so hard that Get started did nothing
    on a demo run. Pressing it unpins.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
2026-10-28 fix(app): place the intro by measurement instead of by spacers
    Three spacers arguing over the same slack is why this kept moving. The
    page places all four things itself: the camera's lit body on the
    middle of the page, the wordmark halfway between the status bar and
    the top of that body, the line under the camera and the button on the
    floor.
    The two constants are the shader's, not guesses: the canvas keeps room
    under the body for its shadow, so the body sits a twentieth of the
    canvas above its centre and starts about a seventh of the way down it.
    Measured off a screenshot, the body's centre now lands two pixels from
    the middle of the page.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
2026-10-28 feat(app): the two tabs lose their headings and their menu
    The blog had a title saying its own handle over a menu of four things,
    one of which was a log nobody asked for and one of which belonged to
    the camera tab. It is two buttons now, people and share, straight in
    the bar, and the camera tab has no heading at all.
    A blog with nothing on it shows the camera with its viewfinder up
    instead of a line of apology.
    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
2026-10-28 feat(app): people get their own screen and the camera tab a real list
    The subscriber modal becomes a People screen of its own: whoever asked to
    follow sits on top with a button that fits, everyone else below, and one
    swipe is the only way out for either. Adding someone is a separate screen.
    The camera tab's hand-rolled sections become a List, so separators, headers
    and sticky behaviour come from UIKit rather than from Rule() and card().
    Stat labels drop to body text so the section headers are the only captions.
    The splash fades instead of cutting: the opacity transition never fired, so
    it is driven by an explicit opacity over half a second.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
2026-10-28 feat: a long press on a picture saves it or takes it off the blog
    The contract first: DELETE /api/camera/feed/:id, claimed phones only, and
    only for a picture on this camera's own blog. The row, its comments and the
    stored PBM go together, so the purge job and the owner now delete the same
    way.
    In the app the picture gets a context menu: save writes the server's own PNG
    to the photo library untouched, delete asks once and drops it from the feed
    before the server answers.
    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
2026-10-28 feat: the owner says something under their own picture
    POST /api/camera/feed/:id/comments, claimed phones only: the camera proves
    the blog, so the comment goes up under the blog's name with nothing further
    asked. The feed now carries each comment's created_at, which it always had
    in the database and never handed out.
    In the app every post gets a line to say something and each comment its time,
    in smaller type: hours while that still means anything, a date after a week.
    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
2026-10-28 feat(app): the demo harness reaches every screen, failures included
    -demo now names each variant rather than each stage: bluetooth off, an update
    mid-flight, one that did not take, a flat battery, a claim link already spent,
    an address being checked and an address taken, the two forms before anything is
    typed, a sync in flight, a camera that stopped answering, storage that never
    mounted, and the two states that live behind the long press.
    The camera's Info is patched from one byte array instead of three copies.
    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
2026-10-28 feat(server): making the blog viewer-only, the app does the managing
    The web keeps only the pages an emailed link opens: confirming an address
    and letting a phone in. Registration, login, the owner's own page and the
    verification QR page are gone, and with them the owner cookie and the
    owner_login token kind. /app lands nowhere and redirects to the apex.
    What survives is restyled after the app's staged screens: one Stage view
    with a header, a heading and a button you can hit, instead of body text at
    the browser's default size.
    docs/protocol.md first, as the contract: it now also documents GET /handle
    and POST /verification-code, which it had never described.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
2026-10-28 feat(site): turning the camera into the phone it posts to
    Every twist of the hero device now comes out as the other thing: the camera
    goes in, the phone comes out with the blog scrolling on it, and the next
    twist brings the camera back wearing its next face. The shape changes while
    the turn has the silhouette edge-on, which is the one frame with nothing to
    show, and the canvas grows for the phone at that same moment.
    The blog is a strip texture flicked rather than crawled: a glide that
    decelerates, then a rest on what it landed on.
    Three bugs the morph turned up, all of them older than it:
    - The canvas measured itself once in connectedCallback, before it had any
    layout, so it sat at 1x1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
2026-10-31 feat: moving onboarding to email-first, adding camera prompts, bind card, and qr blur decoding
2026-10-31 feat: adding blog header with battery indicator, compacting camera tab and keeping firmware awake on usb
2026-10-31 chore(deploy): switch DNS challenge from cloudflare to vercel
2026-10-31 chore(deploy): drop DNS plugin, use on-demand TLS per subdomain
    The caddy-dns/vercel module is broken against current libdns. Per-subdomain
    certs via TLS-ALPN are simpler and need no DNS provider token at all. Caddy
    asks the server whether a subdomain has a verified blog before issuing.
2026-10-31 feat: blog and app polish
    - show first comment for anonymous visitors on blog
    - top-only radial dither in main app screens
    - header fades out over 30pt scroll via onScrollGeometryChange
    - globe button opens blog in safari instead of share sheet
2026-10-31 feat(firmware): radio off in viewfinder, double chirps, fix periodic stall
    Radio only comes up when the sleep face goes up or the camera is on USB,
    saving ~40mA and freeing the CPU for the frame loop. refreshInfo() is
    skipped when no phone is connected, removing the LittleFS.usedBytes()
    traversal that stalled the viewfinder every 500ms. All mood and tap
    chirps now play as pairs.
    Bumps firmware to 0.3.0 (radio lifecycle visible to phone).
2026-10-31 fix(app): auto-start firmware transfer when stage appears
    The FirmwareStage showed the progress screen but never called send(),
    leaving the user stuck on "Freshing up your little camera" at 0%.
2026-10-31 chore(app): lowercase app display name to "little camera"
2026-11-04 feat: adding hold progress feedback, battery hysteresis and bumping to 0.7.0
2026-11-07 feat: capping mood by battery, optimizing viewfinder redraws and bumping to 0.9.0
2026-11-12 feat(server): deploying on push to main with a pull-based systemd timer
    Claude-Session: https://claude.ai/code/session_019Pdyspa6ZAnJniAhfpGFhb
2026-11-12 feat(firmware): adding companion pal system for first photo
    A random pal (Mochi, Sir Croaks, Tweet Seat or Pillowcase) is offered
    when saving a photo with no pal equipped. A blocking dialog shows the
    pal in a spinning starburst with equip/skip buttons and a cheerful
    melody. Equipping persists to NVS and puts the pal on the sleep screen
    (8x, bottom-left) and in the viewfinder face block (3x, swapping with
    the face every 5 seconds). Factory reset clears the pal.
    Claude-Session: https://claude.ai/code/session_019PdysnS7nFtG1cp1Skgbd2
2026-11-12 fix(firmware): replacing starburst with rounded star badge in pal dialog
    Swaps the ray-based starburst for a scalloped badge shape (14 bumps,
    integer-only), adds the battery icon top-left, and shrinks the pal
    from 6x to 4x. Preview scenes added for pal-dialog, sleep-pal and
    viewfinder-pal.
    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
2026-11-12 fix(firmware): reworking the little pal screen into a mode with a rounded star badge
    - Dropping the battery icon from the pal screen; it stays on the sleep face.
    - Replacing the spiky triangle-wave badge with a 12-point star whose tips and
    dips are both filleted, baked as a radius table by badge_profile.py.
    - Running the offer as Mode::PalFound instead of a blocking loop, so BLE,
    toasts and the 30 s review timeout keep working; timing out is a skip.
    - Keeping the skip-hold fill across the 10 fps redraws instead of wiping it.
    - Pinning the sleep-face pal to its first idle frame so a breath cannot tear it.
    - Bumping to 0.9.4 and documenting the mode and preview scenes.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
2026-11-12 fix(firmware): moving the sleep battery top-left and resizing the pals
    - Moving the sleep face's battery badge and debug readout to the top-left,
    leaving the bottom-left corner to the pal, now flush with the bottom edge.
    - Growing the pal screen's badge (r 56 → 78) and pal (5× → 7×), with the
    title on one line to make room.
    - Shrinking the viewfinder face-block pal from 3× to 2×.
    Claude-Session: https://claude.ai/code/session_019PdysqAM61uccMiZvoGTdM
2026-11-12 feat(firmware): adding a pal screen menu entry and shrinking the sleep pal
    - Adding "pal screen" to the menu, which offers a random pal on demand and
    returns to the menu afterwards; equipping replaces the current pal.
    - Shrinking the sleep-face pal from 8× to 6×.
    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
2026-11-12 fix(firmware): animating the pal screen at 30 fps with partial redraws
    The pal screen rebuilt the whole panel every frame, buttons included, and
    took an exact atan2 for every pixel of the badge. The loop spent its time
    there, so the melody and the hold fill lagged behind.
    - Drawing the screen once, then per frame only the badge's square, and
    sending only its rows.
    - Filling the inside of the deepest dip as spans and taking a polynomial
    atan2 only in the ring the lobes live in (~5k angles instead of ~25k).
    - Ticking at 33 ms, with a full frame only when a toast comes or goes.
    - Logging "Pal: N fps" every 5 s so the rate can be checked on a board.
    - Adding a pal-frame preview scene that m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
2026-11-12 feat(firmware): animating the frog, sliding the face-block swap and welcoming a new pal
    - Giving Sir Croaks a sit-blink-sit-hop idle from his own frames; the
    generated one was a single still frame.
    - Sliding the face and the pal through the viewfinder face block when they
    trade places, clipped to the box by new clip columns in setPixel.
    - Adding PalWelcome after equipping: the awake face full screen with the pal
    sliding in from the left and "say hi to <name>", then the wake handoff
    into the viewfinder.
    - Adding pal-welcome and viewfinder-swap preview scenes, bumping to 0.9.6.
    Claude-Session: https://claude.ai/code/session_019Pd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
2026-11-12 fix(firmware): animating the sleep pal and keeping it through the wake
    The sleep face drew the pal's first idle frame only, so it never moved.
    It now idles while the chip is up behind the sleep face, sending only its
    rows when the frame changes, and every sleep render draws the frame last
    sent so a breath cannot tear it. It goes back to its rest pose before
    light sleep. The awake face and the wake exit now keep the pal, its bar
    and its food in their corner instead of dropping them. Bumps to 0.9.8.
    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
2026-11-12 feat(firmware): idling the sleep pal for a few seconds after a tap
    On battery the pal only moved for the 30 s radio window behind the sleep
    face. A tap in light sleep already wakes the chip for its chirp or the
    feeding, so the pal now idles for 4 s after it before going back to its
    rest pose; a press ends that early for the usual GPIO wake. Bumps to 0.9.9.
    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
